larfym/fmcw-radar/Generador de Chirp/Informe/referencias.tex

% ==========================================
% REFERENCIAS
% ==========================================

\renewcommand{\bibname}{Referencias}
\begin{thebibliography}{99}
\setcounter{enumiv}{9}   % clave: va DESPUÉS del \begin, así no te lo pisa \usecounter
\setlength{\itemsep}{0.25em}
\setlength{\parskip}{0pt}
\setlength{\parsep}{0pt}

\bibitem{mitRadar}
C.~R. Rappaport, A.~M. Hersch, M.~A. Saville, and A.~J. Devaney,
``MIT IAP Radar Course: Build a Small Radar System (Coffee Can Radar),''
\emph{Massachusetts Institute of Technology, Lincoln Laboratory},
Lexington, MA, USA, 2011. [En línea]. Disponible en:
\url{https://ocw.mit.edu/courses/electrical-engineering-and-computer-science/6-976-high-frequency-radar-systems-january-iap-2011/}

\bibitem{MarshallBruner}
M. Bruner,
\emph{How Radars Tell Targets Apart (and When They Can’t) | Radar Resolution},
YouTube, 19 abr. 2025.
Disponible en:
\url{https://www.youtube.com/watch?v=MmpPfQ8WoWk}.

\bibitem{MiniCircuitsZX95}
Mini-Circuits,
\emph{ZX95-2536C+ Voltage Controlled Oscillator (VCO) Datasheet}.
Disponible en:
\url{https://www.minicircuits.com/WebStore/dashboard.html?model=ZX95-2536C%2B}

\bibitem{ADF4350}
Analog Devices,
\emph{ADF4350 Wideband Synthesizer with Integrated VCO -- Datasheet}.
Disponible en:
\url{https://www.analog.com/media/en/technical-documentation/data-sheets/ADF4350.pdf}

\bibitem{adf4159}
Analog Devices,
``ADF4159: 13~GHz Fractional-N Frequency Synthesizer with Ramp Generator,''
\emph{Datasheet}, 2019. [En línea].
Disponible en:
\url{https://www.analog.com/}

\bibitem{ADF4159EB3Z}
Analog Devices,
\emph{ADF4159EB3Z Evaluation Board for the ADF4159 PLL Synthesizer}.
Disponible en:
\url{https://www.analog.com/en/resources/evaluation-hardware-and-software/evaluation-boards-kits/eval-adf4159.html}

\bibitem{harney_pll}
A.~Harney,
``Designing High-Performance Phase-Locked Loops with High-Voltage VCOs,''
\emph{Analog Dialogue}.

\bibitem{gua_chirp}
C.~Gua, R.~Ding, Y.~Gao, G.~D.~Huang, D.~Sun, and S.~Liu,
``A Linear Chirp Generator with 2nd DPD Technique based on a Type-III SPLL.''

\bibitem{crystekVCO}
Crystek,
``CVCOS55BE Series VCO,''
\emph{Datasheet}, 2024. [En línea].
Disponible en:
\url{https://www.crystek.com/}

\bibitem{A Hasan}
A.~Hasan,
\emph{Novel Microstrip Hairpinline Narrowband Bandpass Filter Using Via Ground Holes}.

\bibitem{Chemandy}
Chemandy,
\emph{Coplanar Waveguide with Ground Calculator}.
Disponible en:
\url{https://chemandy.com/calculators/coplanar-waveguide-with-ground-calculator.htm}

\bibitem{StackExchangeVias}
Electronics Stack Exchange,
\emph{How to calculate distances between stitching vias for RF lines?}
Disponible en:
\url{https://electronics.stackexchange.com/questions/707177/how-to-calculate-distances-between-stitching-vias-for-rf-lines}

\bibitem{HansRosenbergVias}
Hans Rosenberg,
\emph{Why Ground Planes Can Break RF... And How to Fix It}.
Disponible en:
\url{https://www.youtube.com/watch?v=vumYrebIXm0}

\bibitem{AnalogDevices2012ADIsimPLL}
Analog Devices,
\emph{Using ADIsimPLL to Simulate Frequency Ramps on the ADF4158},
video, 18 de septiembre de 2012.
Disponible en:
\url{https://www.analog.com/en/resources/media-center/videos/1846356091001.html}.

\bibitem{AnalogDevices2015ADF4158}
Analog Devices,
``ADF4158 \& ADF4159 loop filter design,''
\emph{EngineerZone -- RF \& Microwave},
23 de junio de 2015.
Disponible en:
\url{https://ez.analog.com/rf/f/q-a/74295/adf4158-adf4159-loop-filter-design}.

\bibitem{op184}
Analog Devices,
``OP184/OP284/OP484: Precision Rail-to-Rail Input and Output Operational Amplifiers,''
\emph{Datasheet}. [En línea].
Disponible en:
\url{https://www.analog.com/}

\bibitem{LM7805}
Texas Instruments,
``LM340-N/LM78xx Positive-Voltage Regulators,''
\emph{Datasheet}. [En línea].
Disponible en:
\url{https://www.ti.com/lit/ds/symlink/lm340.pdf}

\end{thebibliography}
