larfym/fmcw-radar/Generador de Chirp/Informe/preambulo/acta aprobacion.tex

\thispagestyle{empty}

\begin{center}

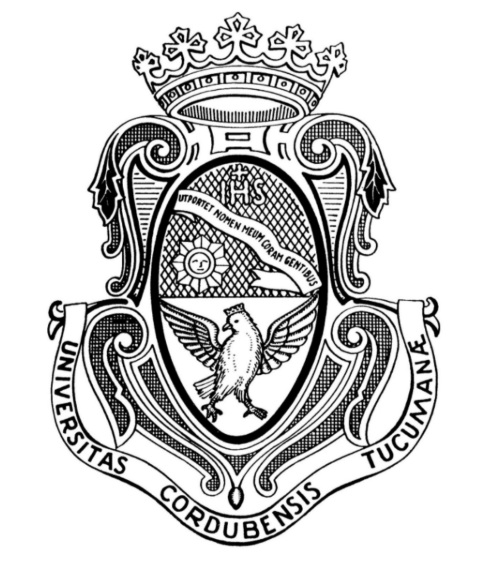
[picture p1: Generador de Chirp/Informe/imagenes/Escudo UNC.png]


\vspace{0.5cm}

{\Large\scshape Universidad Nacional de Córdoba}

\vspace{0.2cm}

{\large\scshape Facultad de Ciencias Exactas, Físicas y Naturales}

\vspace{0.2cm}

{\large\scshape Escuela de Ingeniería Electrónica}

\end{center}

\vspace{1.5cm}

\noindent
El Tribunal Evaluador reunido en este acto y luego de haber aprobado la Solicitud de
Aprobación de Tema y efectuado las distintas instancias de correcciones del Informe del
Proyecto Integrador para la obtención del Título de Grado ``Ingeniero Electrónico'' y
cumpliendo con el Reglamento correspondiente, declara el Informe Final del estudiante
\textbf{Cesana, Andrés Agustín} como ``aceptado sin correcciones'' y la defensa oral
Aprobada. Por lo tanto, luego de haber tenido en cuenta los aspectos de evaluación que
indica el Reglamento, el Proyecto Integrador se considera Aprobado.

\vspace{1cm}

\noindent
Se firma el Acta de Examen correspondiente y se distribuyen los ejemplares impresos.

\vfill

\noindent
Firma y aclaración del Tribunal Evaluador

\vspace{1.5cm}

\noindent
Fecha: \rule{6cm}{0.4pt}

\clearpage
