larfym/fmcw-radar/Generador de Chirp/Informe/preambulo/caratula.tex

\begin{titlepage}
\begin{center}

% --- Escudo ---
\\[1.5cm] % Asegurate de tener el archivo en la misma carpeta

{\centering
{\LARGE
\textbf{UNIVERSIDAD NACIONAL DE CÓRDOBA}}\\[0.5cm]
{\large
{FACULTAD DE CIENCIAS EXACTAS FÍSICAS Y NATURALES}\\[0.5cm]
{CARRERA INGENIERÍA ELECTRÓNICA }}}
\\[2.0cm] 
PROYECTO INTEGRADOR PARA LA OBTENCIÓN DEL TÍTULO DE GRADO DE INGENIERO ELECTRÓNICO \\
[2.0cm]
{\textbf{\large "DISEÑO E IMPLEMENTACIÓN DE UN GENERADOR DE CHIRP PARA RADARES FMCW"}}\\
[1.0cm]

\hrule height 1pt
\vspace{0.5cm}
\hrule height 1pt
\vspace{1cm}

\textbf{ALUMNO:}\\ CESANA, ANDRÉS AGUSTÍN\\[0.5cm]
\textbf{DIRECTOR:}\\ FEDERICO TOMÁS DADAM \\[0.5cm]
\textbf{CO-DIRECTOR:}\\ FEDERICO EXEQUIEL HENRIQUEZ\\[2.2cm]

% --- Autor ---
{Córdoba, República Argentina\\
Septiembre / 2026}

\end{center}
\end{titlepage}
\clearpage
