larfym/fmcw-radar/Generador de Chirp/Informe/preambulo/director.tex

\clearpage
\thispagestyle{empty}

\begin{center}



\vspace{0.5cm}

{\Large\scshape Universidad Nacional de Córdoba}

\vspace{0.2cm}

{\large\scshape Facultad de Ciencias Exactas, Físicas y Naturales}

\vspace{0.2cm}

{\large\scshape Escuela de Ingeniería Electrónica}

\end{center}

\vspace{1.5cm}

\begin{center}
\begin{minipage}{0.85\textwidth}

\noindent
Quien suscribe el Profesor \textbf{Dadam, Federico Tomás} en su carácter de Director
del Proyecto Integrador del estudiante \textbf{Cesana, Andrés Agustín}, denominado:

\begin{center}
\textbf{``DISEÑO E IMPLEMENTACIÓN DE UN GENERADOR DE CHIRP PARA RADARES FMCW''}
\end{center}

considera que el desarrollo del trabajo se ha completado según lo especificado en la
Solicitud de Aprobación de Tema y se encuentra en condiciones de tramitar su defensa.

\vspace{0.8cm}

\noindent
A los efectos de quien corresponda, en fecha \rule{4cm}{0.4pt} de
\rule{4cm}{0.4pt} de 2026.

\vspace{3cm}

\begin{flushright}
\rule{7cm}{0.4pt}\\
Firma del Director
\end{flushright}

\end{minipage}
\end{center}

\clearpage
