larfym/fmcw-radar/Generador de Chirp/Informe/preambulo/lista de acronimos.tex

\chapter*{Lista de Acrónimos} 
\noindent\textbf{ADS}{Advanced Design System}\\
\textbf{CAD}{Computer-Aided Design}\\
\textbf{CPWG}{Coplanar Waveguide with Ground}\\
\textbf{FMCW}{Frequency-Modulated Continuous-Wave}\\
\textbf{LARFyM}{Laboratorio de Radiofrecuencia y Microondas}\\
\textbf{LFM}{Linear Frequency Modulation}\\
\textbf{LNA}{Low Noise Amplifier}\\
\textbf{MXR}{Mixer}\\
\textbf{OCXO}{Oven Controlled Crystal Oscillator}\\
\textbf{PA}{Power Amplifier}\\
\textbf{PCB}{Printed Circuit Board}\\
\textbf{PFD}{Phase Frequency Detector}\\
\textbf{PLL}{Phase-Locked Loop}\\
\textbf{PSK}{Phase Shift Keying}\\
\textbf{RADAR}{Radio Detection and Ranging}\\
\textbf{RF}{Radiofrecuencia}\\
\textbf{SDR}{Software Defined Radio}\\
\textbf{TCXO}{Temperature Compensated Crystal Oscillator}\\
\textbf{UV}{Ultravioleta}\\
\textbf{VCO}{Voltage Controlled Oscillator}\\
\textbf{VCXO}{Voltage Controlled Crystal Oscillator}\\
\textbf{XO}{Crystal Oscillator}
