larfym/fmcw-radar/Generador de Chirp/Informe/bibliografia.tex

% ==========================================
% BIBLIOGRAFÍA
% ==========================================
\renewcommand{\bibname}{Bibliografía}
\begin{thebibliography}{99}
\setlength{\itemsep}{0.25em}
\setlength{\parskip}{0pt}
\setlength{\parsep}{0pt}

\bibitem{Charvat2014}
G.~L. Charvat, \emph{Small and Short-Range Radar Systems}.

\bibitem{Dean Banerjee}
D. Banerjee, \emph{PLL Performance, Simulation, and Design}, 2.\,ed.

\bibitem{pozar}
D.~M. Pozar, \emph{Microwave Engineering}, 4.\,ed. Hoboken, NJ: Wiley, 2012.

\bibitem{skolnik2001}
M.~I. Skolnik, \emph{Introduction to Radar Systems}, 3.\,ed. New York, NY: McGraw-Hill Education, 2001.

\bibitem{richards2014}
M.~A. Richards, \emph{Fundamentals of Radar Signal Processing}, 2.\,ed. New York, NY: McGraw-Hill Education, 2014.

\bibitem{Andy Harrison}
A.~Harrison, \emph{Design and Implementation of FMCW Radar Systems for Range and Velocity Measurement}.
Tesis de Maestría, University of Leeds, Reino Unido, 2018.

\bibitem{CervettoDadam2019}
R.~H. Cervetto and F.~T. Dadam,
\emph{UP Converter de HF a UHF para aplicaciones LTE}.
Proyecto Integrador para la obtención del título de grado de Ingeniero Electrónico,
Facultad de Ciencias Exactas, Físicas y Naturales,
Universidad Nacional de Córdoba,
Córdoba, República Argentina, junio de 2019.

\bibitem{HongLancaster}
J.-S.~G. Hong and M.~J. Lancaster,
\emph{Microstrip Filters for RF/Microwave Applications}.
New York, NY: John Wiley \& Sons, 2001.

\bibitem{Matthaei}
G.~L. Matthaei, L.~Young, and E.~M.~T. Jones,
\emph{Microwave Filters, Impedance-Matching Networks, and Coupling Structures}.
Norwood, MA: Artech House, 1980.

\end{thebibliography}
