larfym/fmcw-radar/Generador de Chirp/Informe/preambulo/lista de tablas.tex

\chapter*{Lista de Tablas} 
\addcontentsline{toc}{chapter}{Lista de Tablas}
