larfym/fmcw-radar/Generador de Chirp/Practica Supervisada/Datos administrativos/Gantt PS Andrés Agustín Cesana.docx

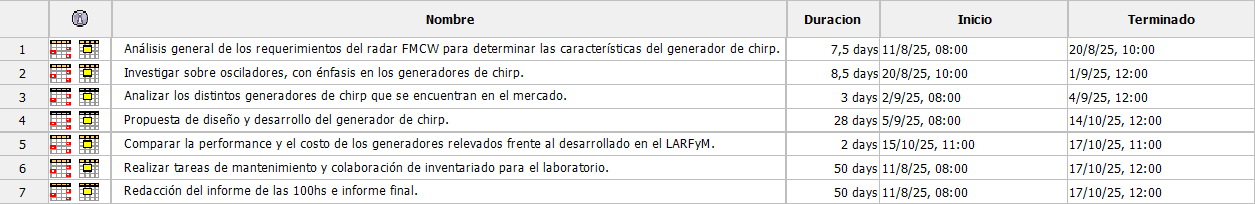
[picture p75: figure]
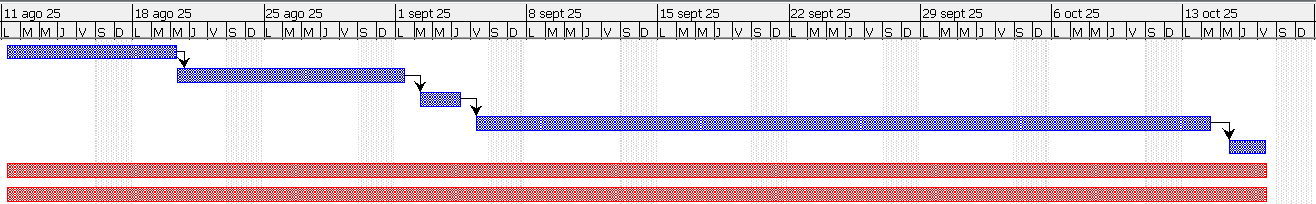
[picture p76: figure]
