larfym/fmcw-radar/Generador de Chirp/Proyecto Integrador/filtro lazo/filtro1mascara.pdf

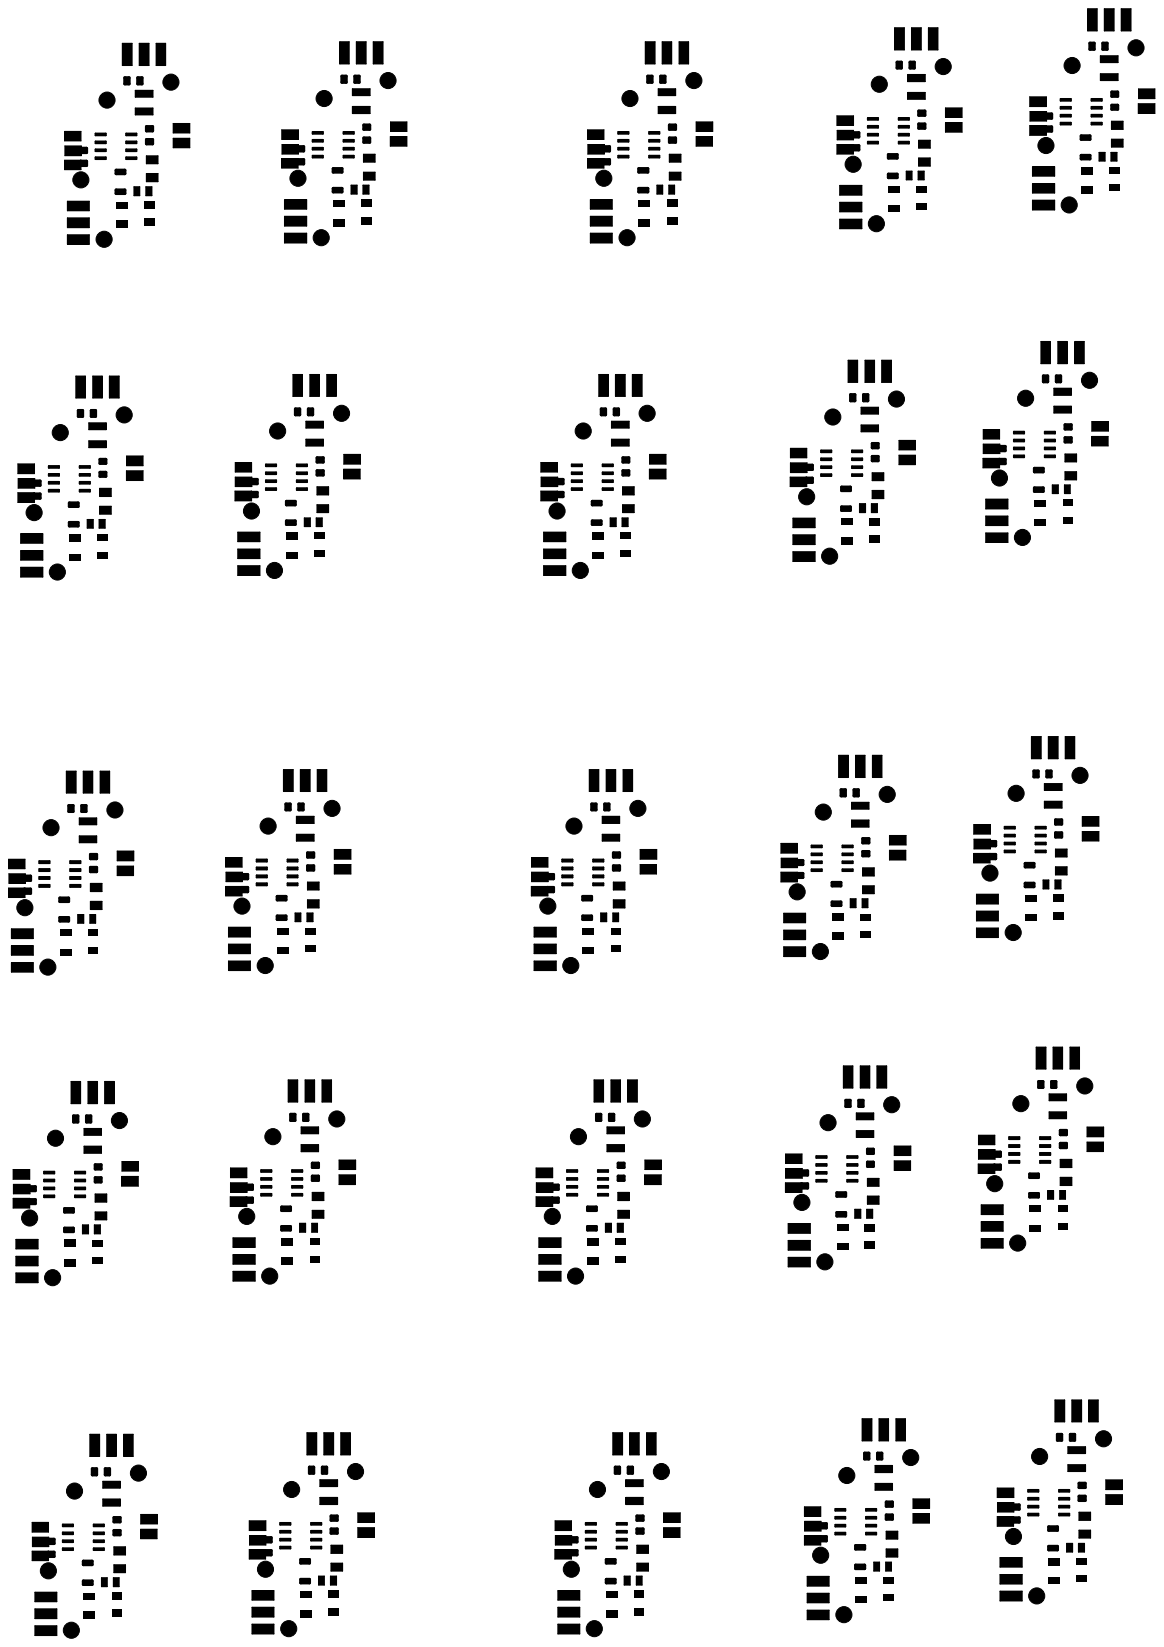
[picture p77: page 1]
