larfym/fmcw-radar/Generador de Chirp/Proyecto Integrador/filtro lazo/filtro2masc.pdf

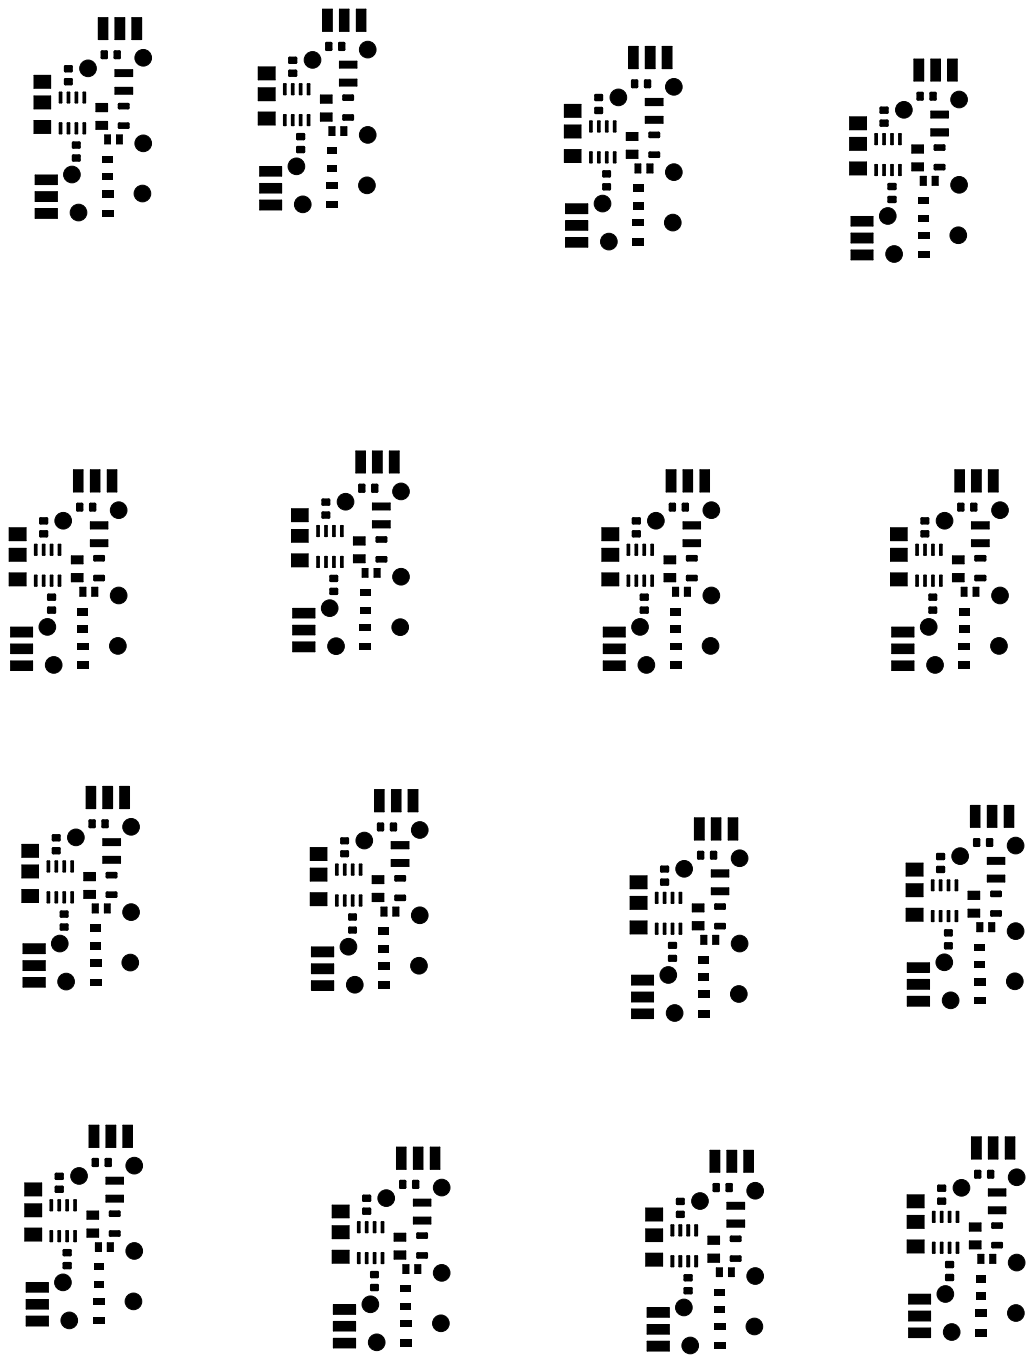
[picture p78: page 1]
