larfym/fmcw-radar/Generador de Chirp/Proyecto Integrador/filtro lazo/filtro3mascara.pdf

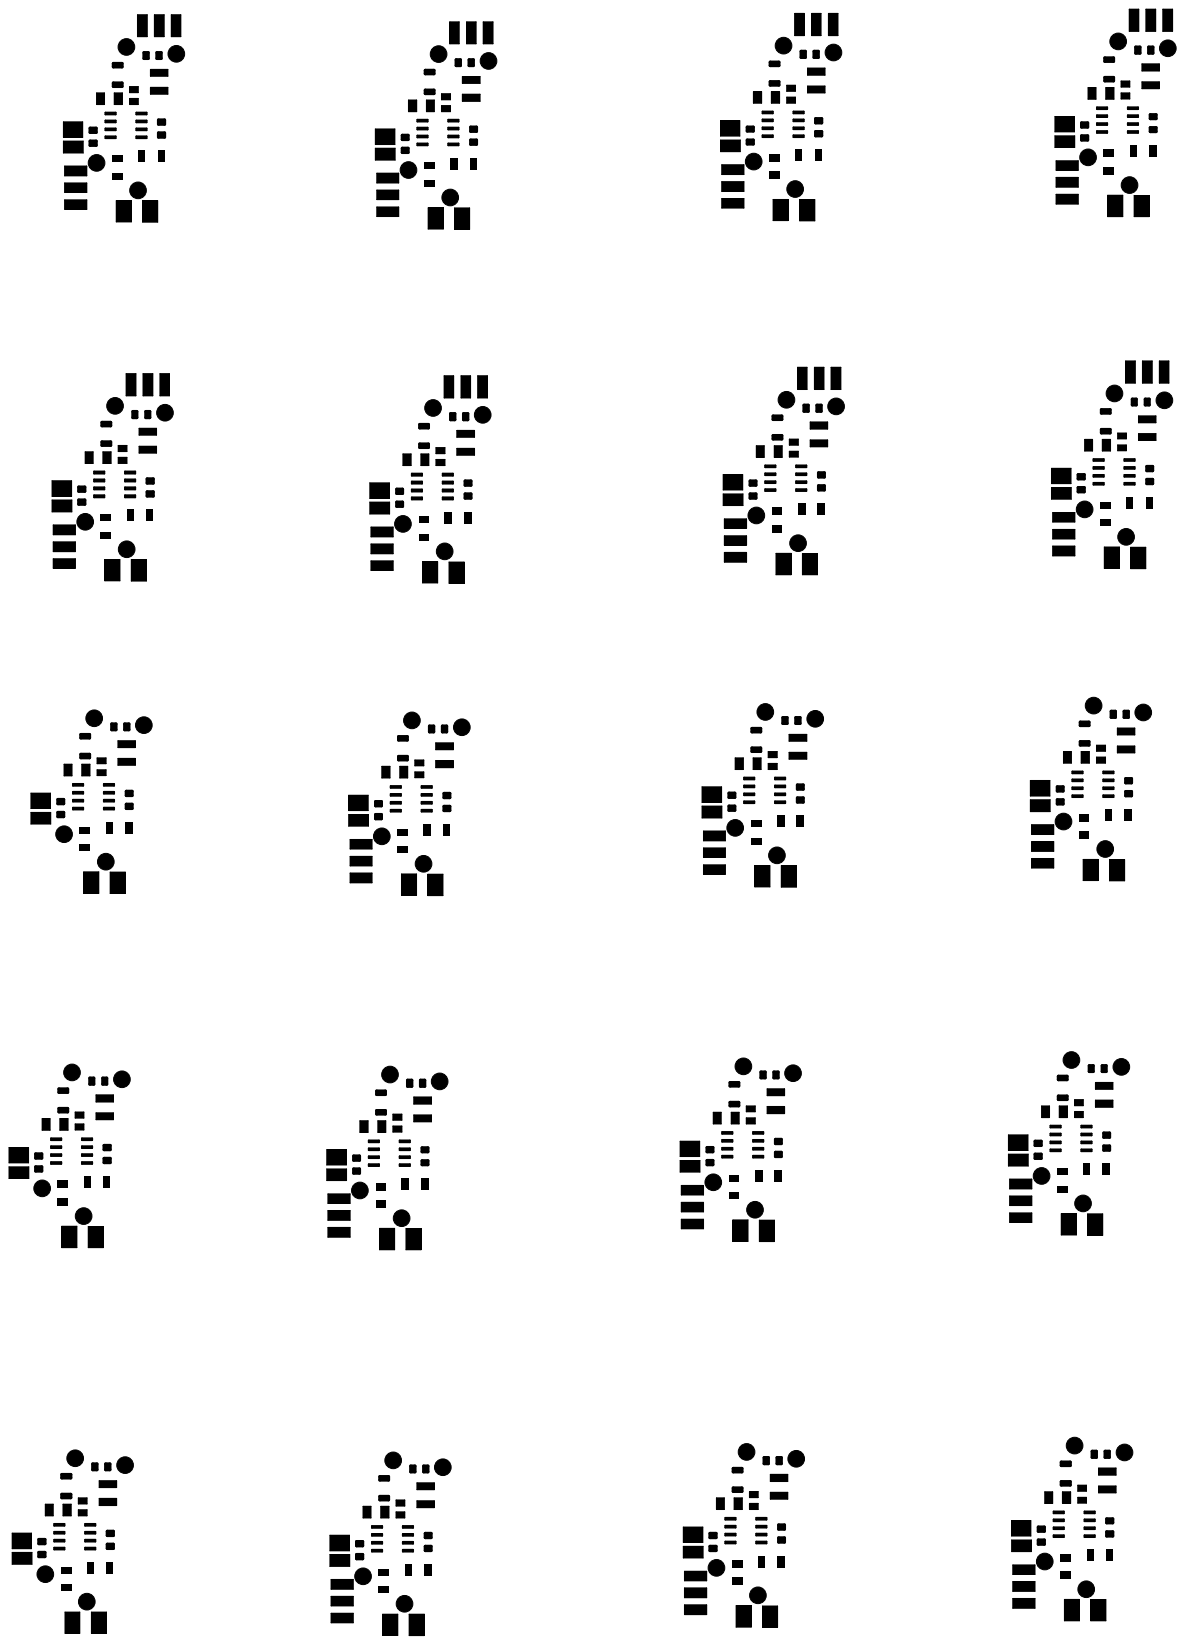
[picture p79: page 1]
