larfym/fmcw-radar/Generador de Chirp/Informe/imagenes/Diagrama en bloque PLL.png

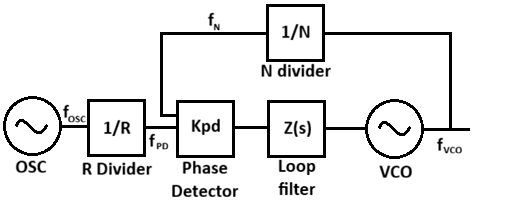
Generador de Chirp/Informe/imagenes/Diagrama en bloque PLL.png
