larfym/fmcw-radar/Generador de Chirp/Informe/imagenes/funcion de transferencia.png

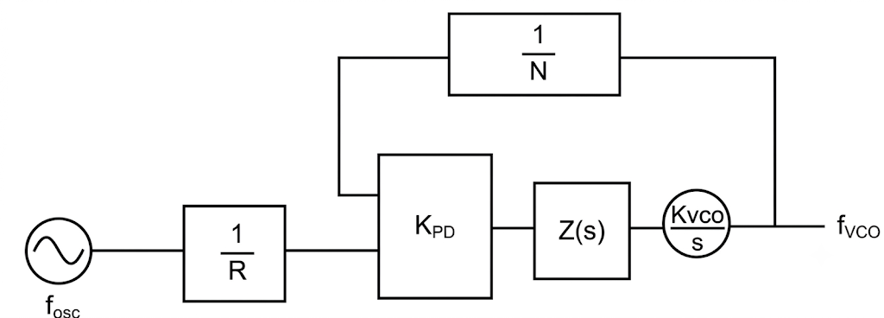
Generador de Chirp/Informe/imagenes/funcion de transferencia.png
