larfym/fmcw-radar/Generador de Chirp/Practica Supervisada/Descarga osciloscopio/NewFile0.bmp

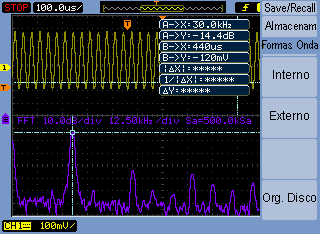
Generador de Chirp/Practica Supervisada/Descarga osciloscopio/NewFile0.bmp
