larfym/fmcw-radar/Generador de Chirp/Practica Supervisada/Imagenes/Capacidad de exitacion.png

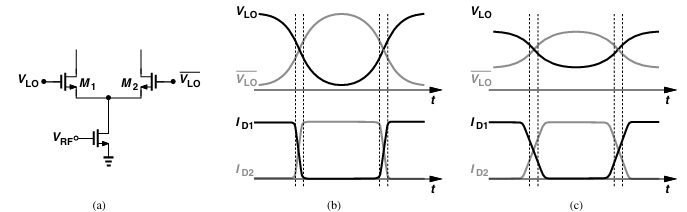
Generador de Chirp/Practica Supervisada/Imagenes/Capacidad de exitacion.png
