larfym/fmcw-radar/Generador de Chirp/Practica Supervisada/Imagenes/Condicion de frontera.png

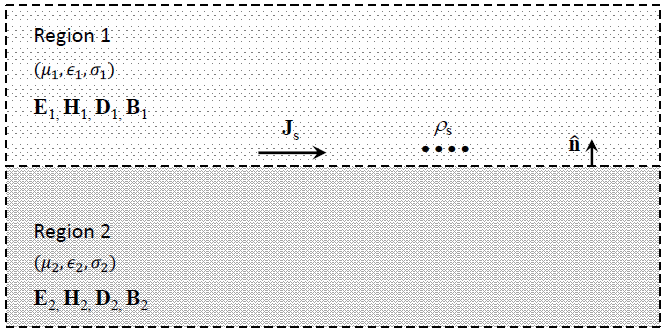
Generador de Chirp/Practica Supervisada/Imagenes/Condicion de frontera.png
