larfym/fmcw-radar/Generador de Chirp/Practica Supervisada/Imagenes/Oscilador cruz doble.png

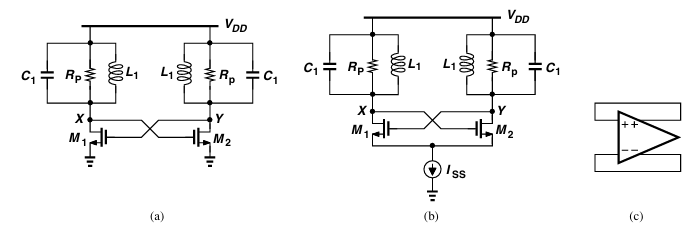
Generador de Chirp/Practica Supervisada/Imagenes/Oscilador cruz doble.png
