larfym/fmcw-radar/Generador de Chirp/Practica Supervisada/Imagenes/Oscilador cruz.png

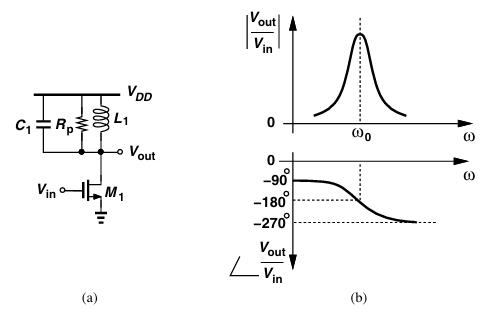
Generador de Chirp/Practica Supervisada/Imagenes/Oscilador cruz.png
