larfym/fmcw-radar/Generador de Chirp/Practica Supervisada/Imagenes/Oscilador de tres puerto.png

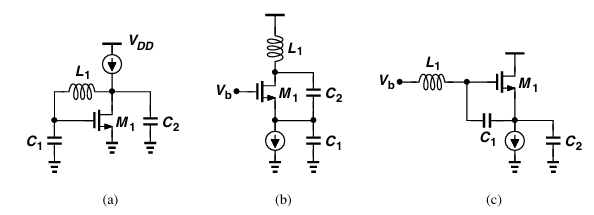
Generador de Chirp/Practica Supervisada/Imagenes/Oscilador de tres puerto.png
