larfym/fmcw-radar/Generador de Chirp/Practica Supervisada/Imagenes/Oscilador de un puerto.png

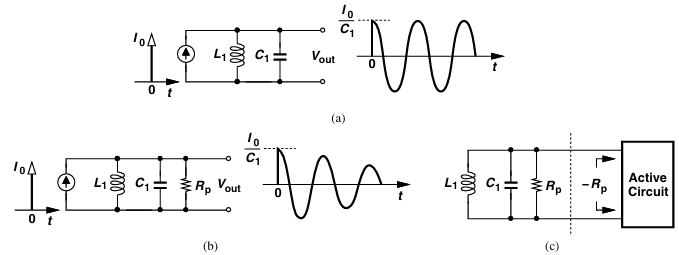
Generador de Chirp/Practica Supervisada/Imagenes/Oscilador de un puerto.png
