larfym/fmcw-radar/Generador de Chirp/Practica Supervisada/Imagenes/Oscilador tres diferencial.png

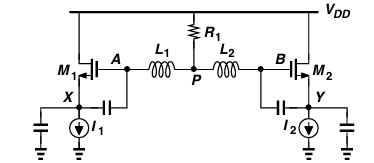
Generador de Chirp/Practica Supervisada/Imagenes/Oscilador tres diferencial.png
