larfym/fmcw-radar/Generador de Chirp/Practica Supervisada/Imagenes/Radar FMCW bloques.png

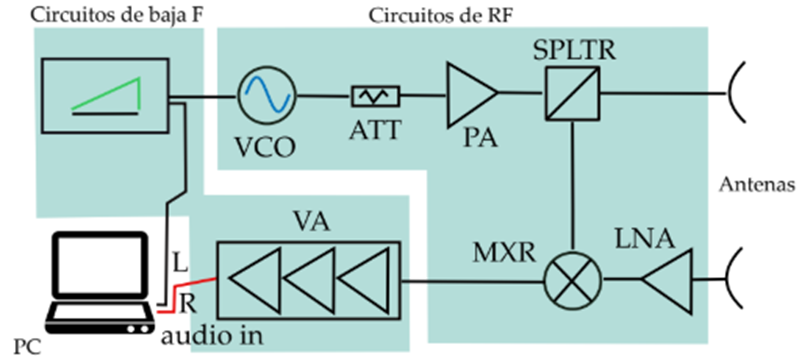
Generador de Chirp/Practica Supervisada/Imagenes/Radar FMCW bloques.png
