larfym/fmcw-radar/Generador de Chirp/Practica Supervisada/Imagenes/rampa.png

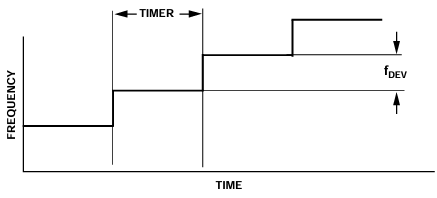
Generador de Chirp/Practica Supervisada/Imagenes/rampa.png
