larfym/fmcw-radar/Generador de Chirp/Practica Supervisada/Imagenes/Sin título.png

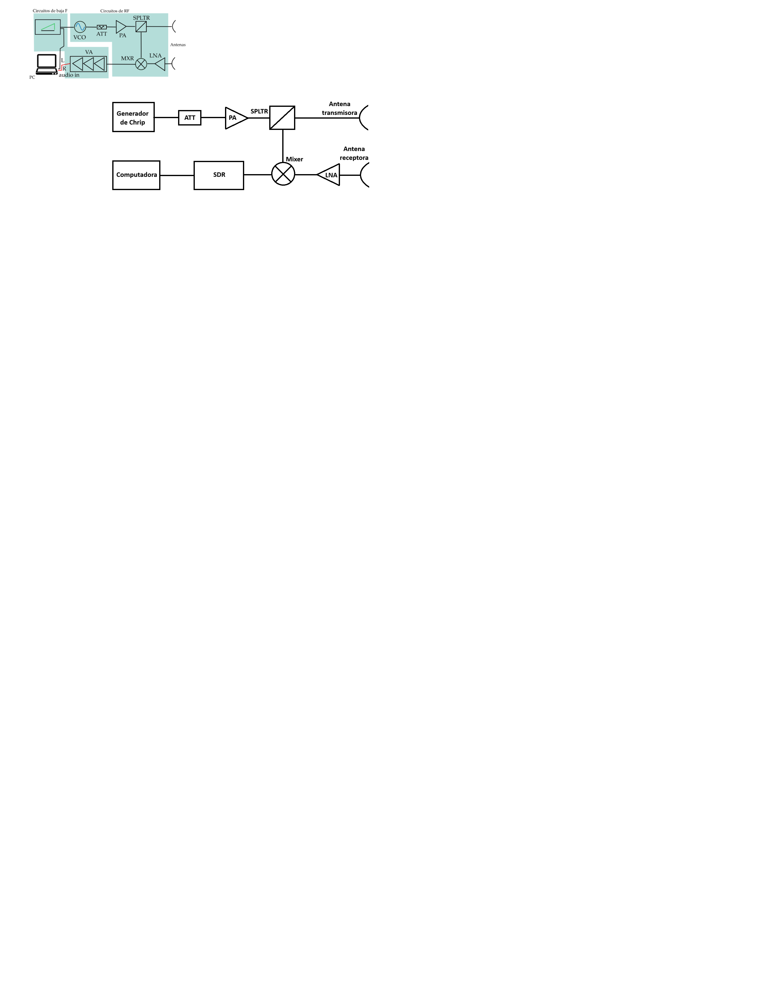
Generador de Chirp/Practica Supervisada/Imagenes/Sin título.png
