larfym/fmcw-radar/Generador de Chirp/Practica Supervisada/Imagenes/VCO recta.png

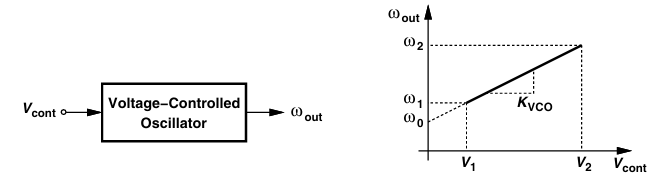
Generador de Chirp/Practica Supervisada/Imagenes/VCO recta.png
