larfym/fmcw-radar/Generador de Chirp/Practica Supervisada/Imagenes/vco varicap.png

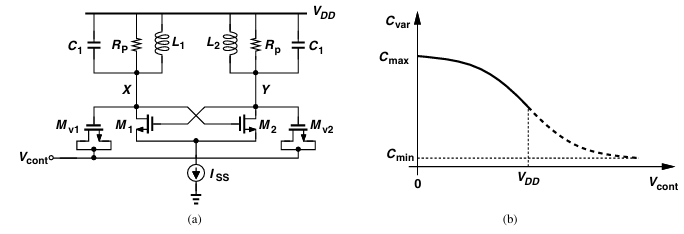
Generador de Chirp/Practica Supervisada/Imagenes/vco varicap.png
