larfym/fmcw-radar/Generador de Chirp/Practica Supervisada/Simulaciones/beat_BW_25MHz.png

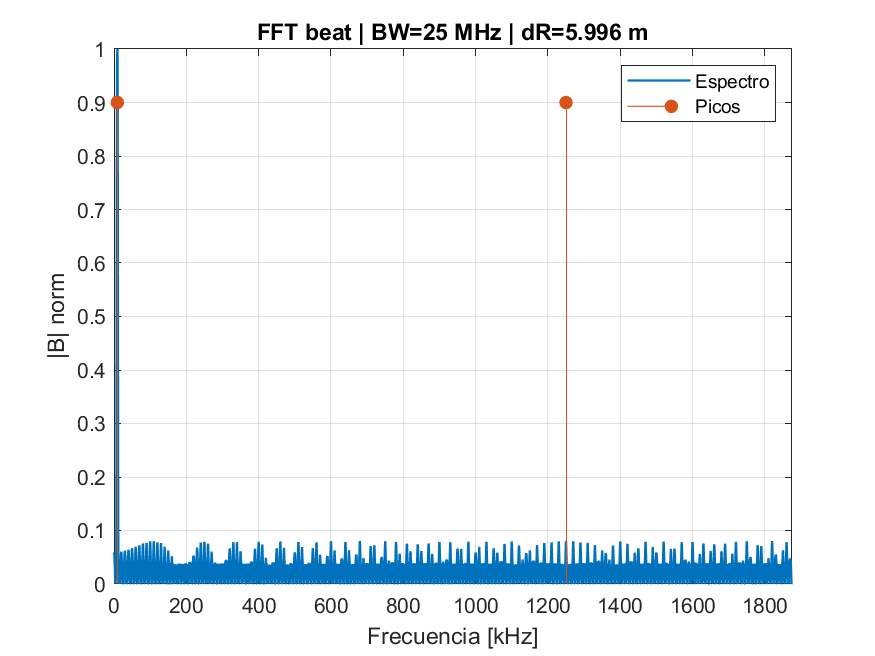
Generador de Chirp/Practica Supervisada/Simulaciones/beat_BW_25MHz.png
