larfym/fmcw-radar/Generador de Chirp/Practica Supervisada/Simulaciones/beat_BW_300MHz.png

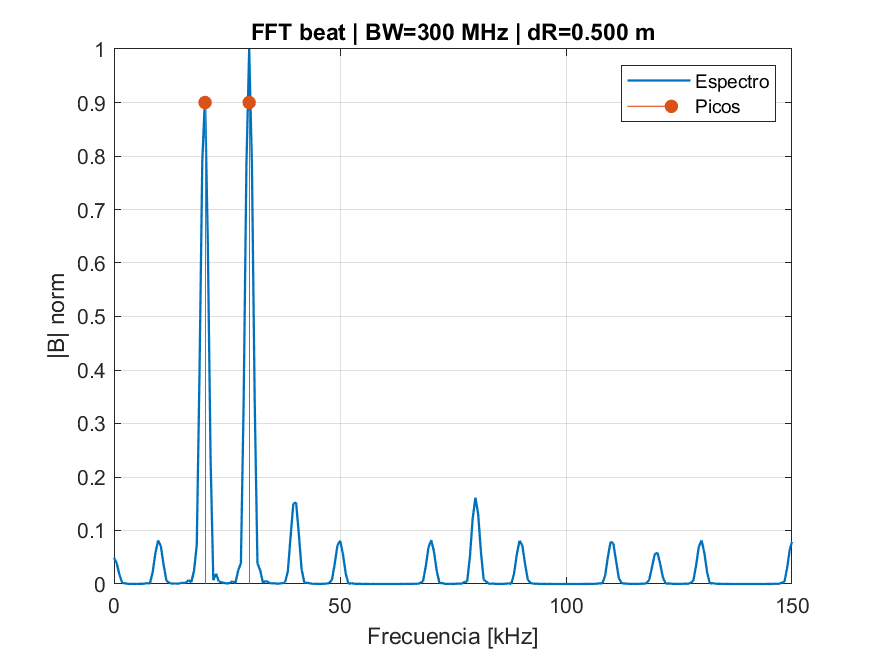
Generador de Chirp/Practica Supervisada/Simulaciones/beat_BW_300MHz.png
