larfym/fmcw-radar/Generador de Chirp/Practica Supervisada/Simulaciones/deteccion_coherente.png

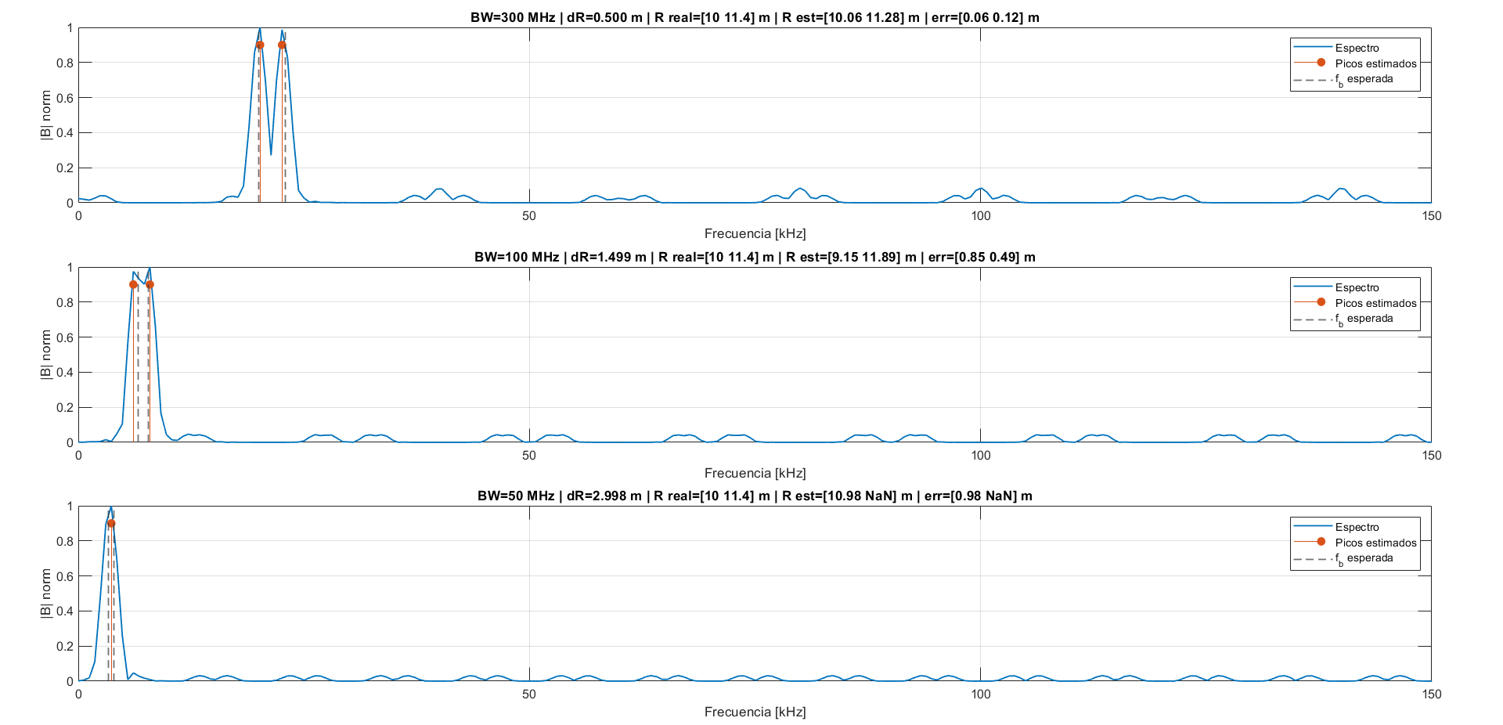
Generador de Chirp/Practica Supervisada/Simulaciones/deteccion_coherente.png
