larfym/fmcw-radar/Generador de Chirp/Proyecto Integrador/coupler/s11_s13.png

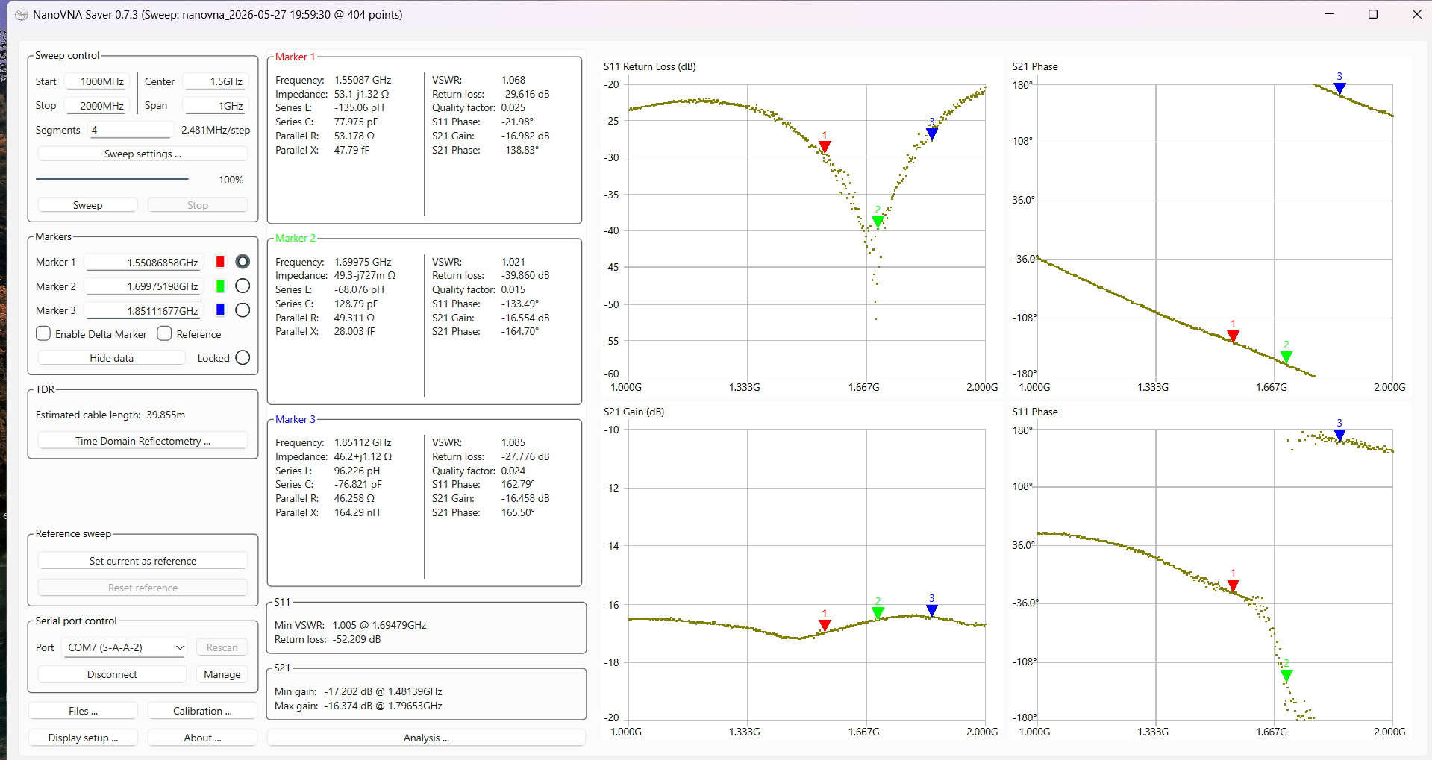
Generador de Chirp/Proyecto Integrador/coupler/s11_s13.png
