larfym/fmcw-radar/Generador de Chirp/Proyecto Integrador/coupler/s12.png

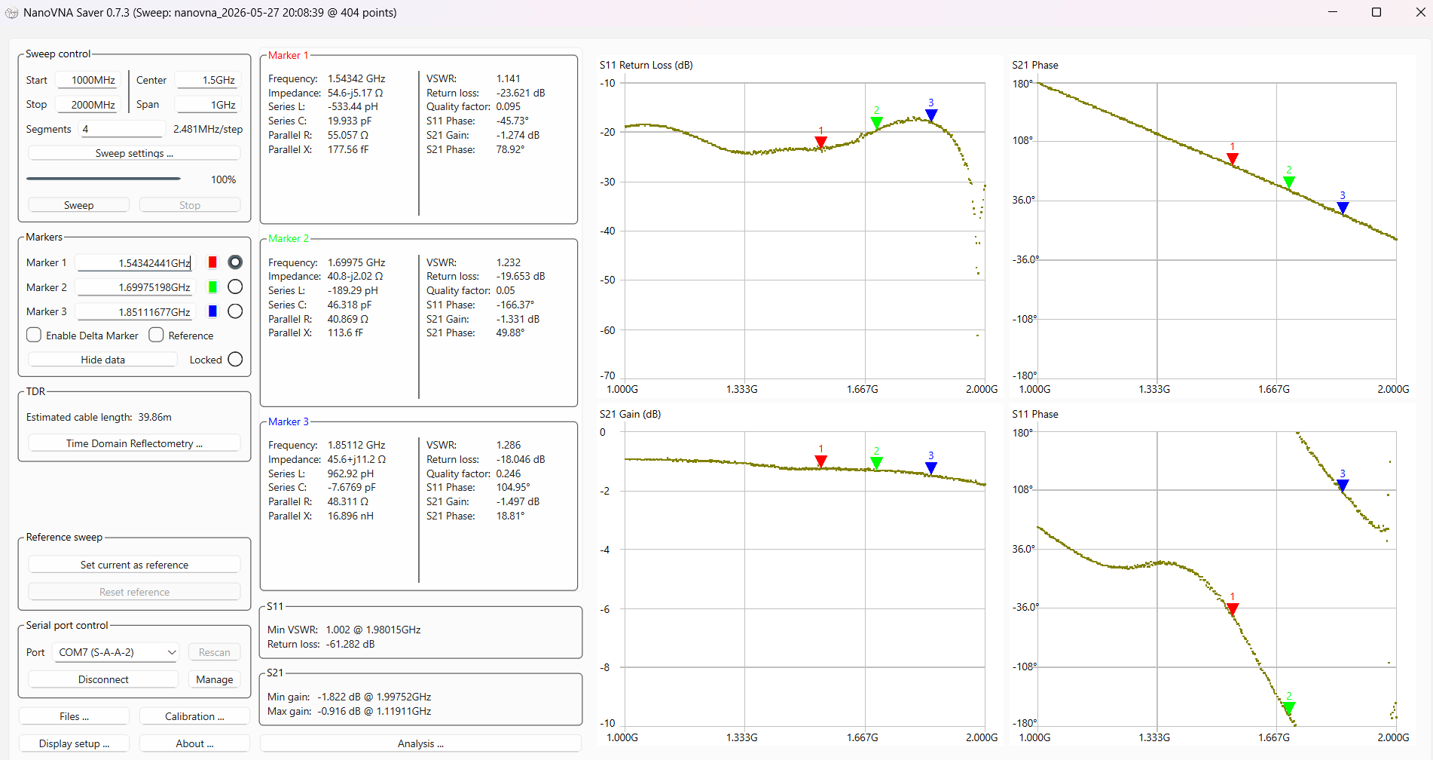
Generador de Chirp/Proyecto Integrador/coupler/s12.png
