larfym/fmcw-radar/Generador de Chirp/Proyecto Integrador/coupler/s23.png

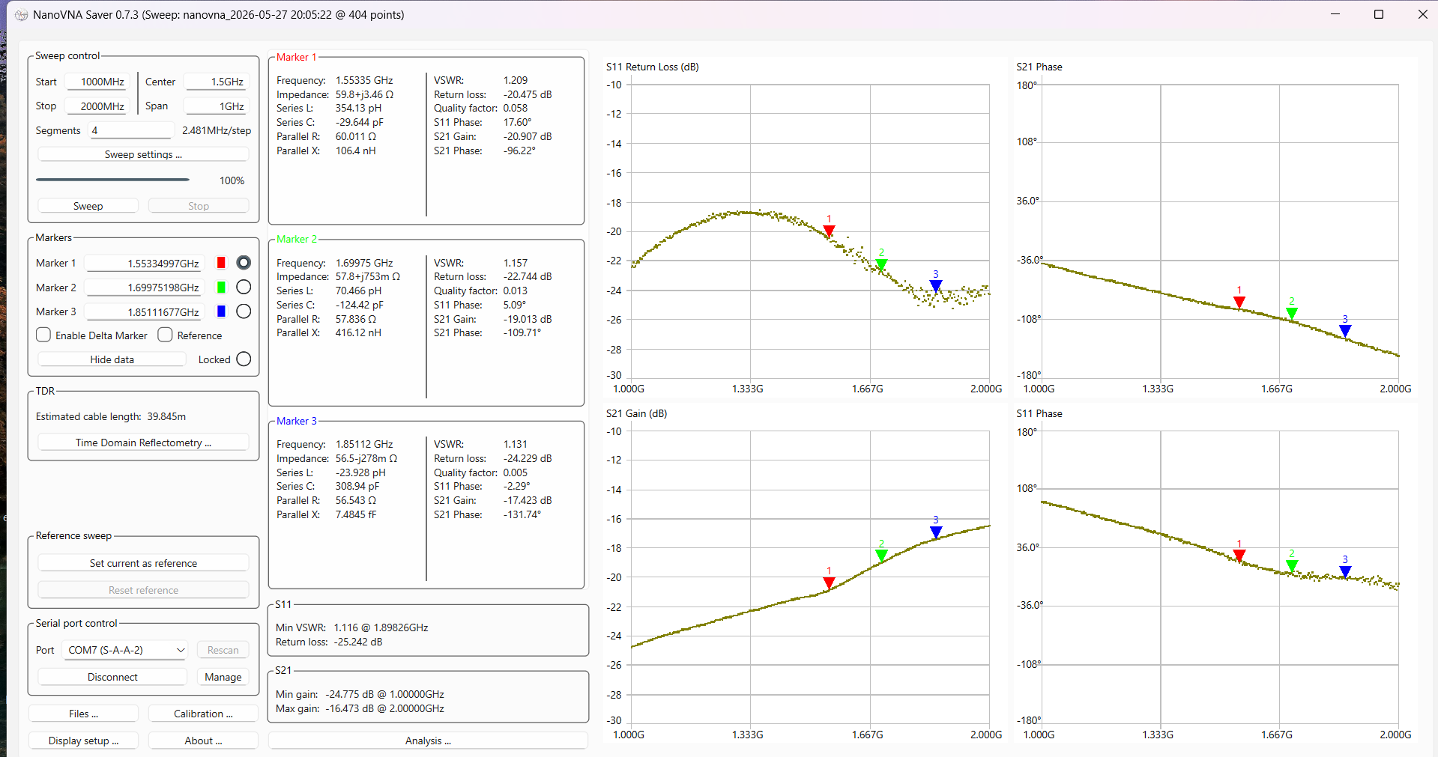
Generador de Chirp/Proyecto Integrador/coupler/s23.png
