larfym/fmcw-radar/Generador de Chirp/Proyecto Integrador/filtrowilk/s11_filt.png

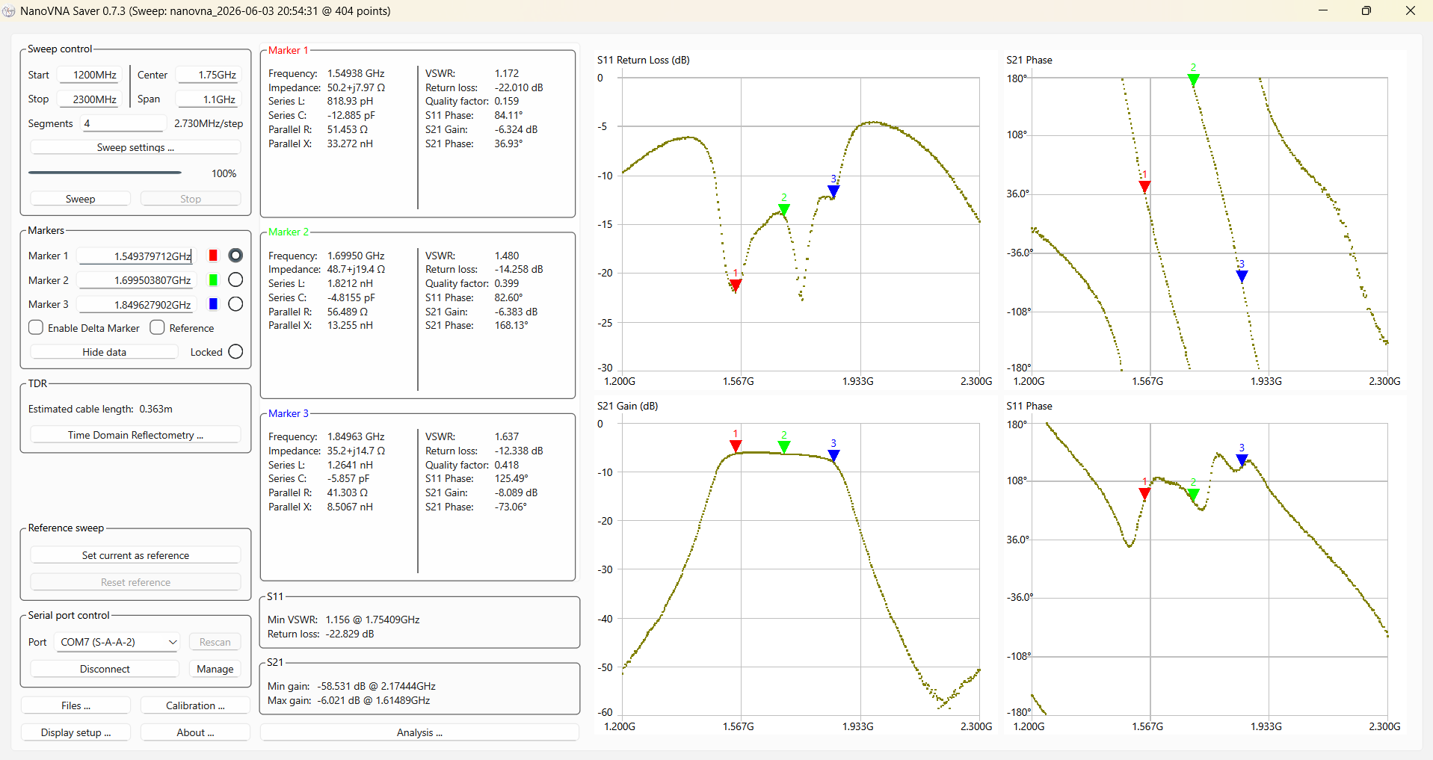
Generador de Chirp/Proyecto Integrador/filtrowilk/s11_filt.png
