larfym/fmcw-radar/Generador de Chirp/Proyecto Integrador/filtrowilk/s11_wilk.png

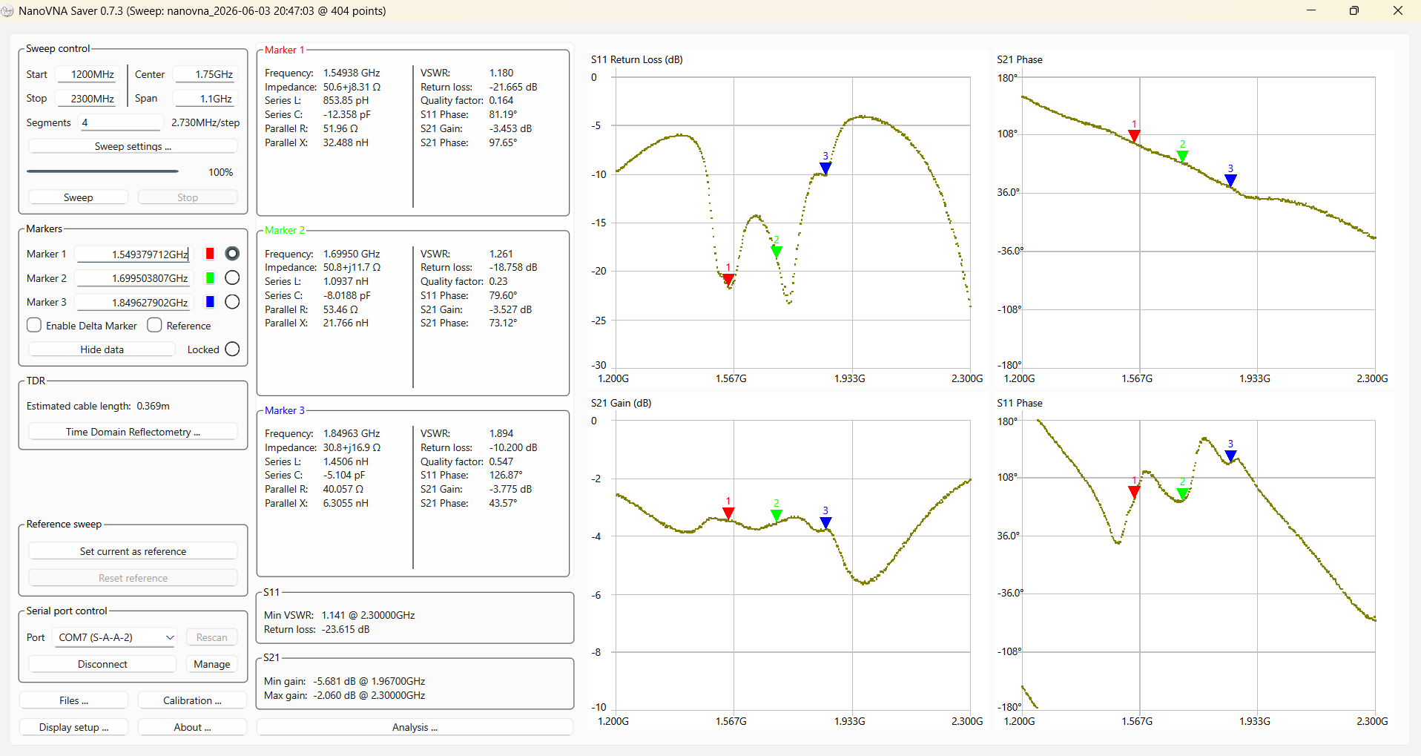
Generador de Chirp/Proyecto Integrador/filtrowilk/s11_wilk.png
