larfym/fmcw-radar/Generador de Chirp/Proyecto Integrador/caja/caja_parte_1.stl

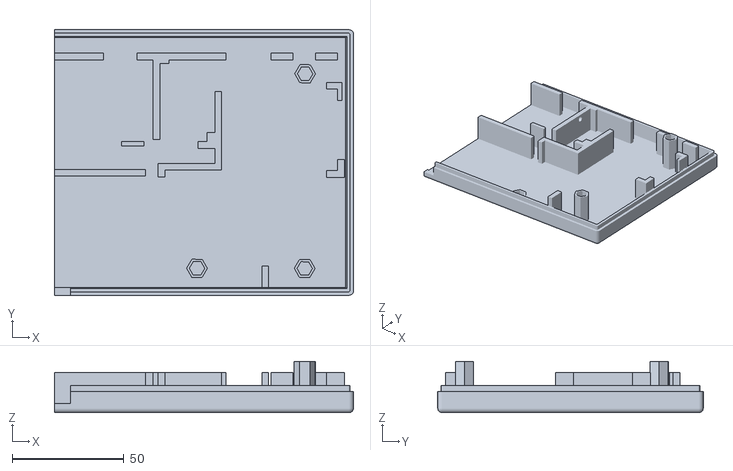
[picture p107: CAD file, 2026-09-05]
Generador de Chirp/Proyecto Integrador/caja/caja_parte_1.stl
134.0 x 119.0 x 23.0
