larfym/fmcw-radar/Generador de Chirp/Proyecto Integrador/filtro lazo/C0805C104K5RACTU/CAPC220145_88N_KEM.stl

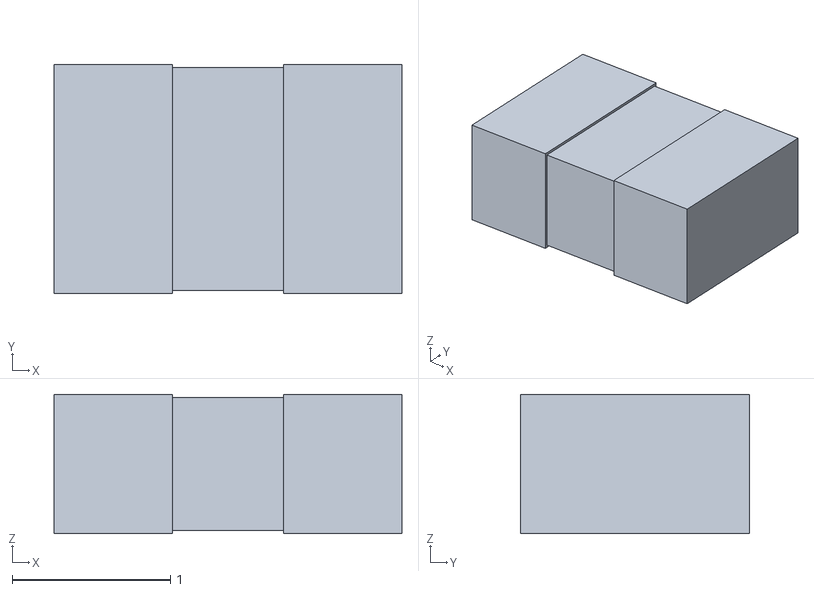
[picture p108: CAD file, 2026-09-05]
Generador de Chirp/Proyecto Integrador/filtro lazo/C0805C104K5RACTU/CAPC220145_88N_KEM.stl
2.20 x 1.45 x 0.88
