larfym/fmcw-radar/Generador de Chirp/Proyecto Integrador/filtro lazo/CON-SMA-EDGE-S/CON-SMA-EDGE-S.step

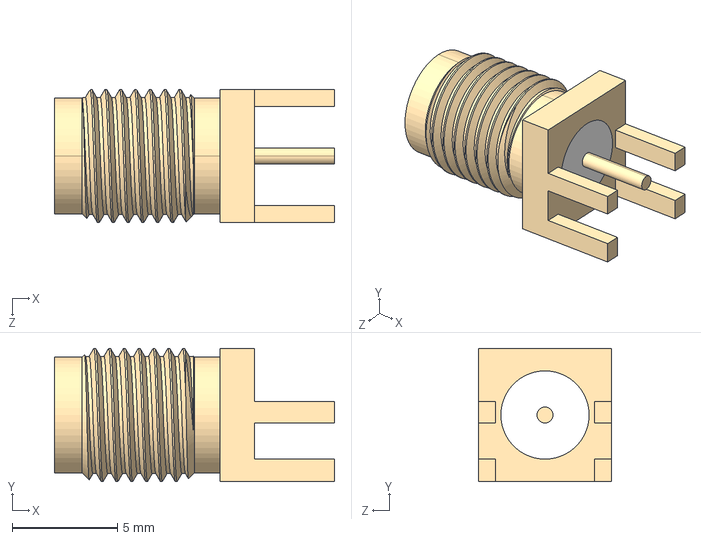
[picture p109: CAD file, 2026-09-05]
Generador de Chirp/Proyecto Integrador/filtro lazo/CON-SMA-EDGE-S/CON-SMA-EDGE-S.step
13.3 x 6.35 x 6.35 mm
