larfym/fmcw-radar/Generador de Chirp/Proyecto Integrador/filtro lazo/GRM31A5C2J221FW01D/GRM31A5C2J221FW01D.step

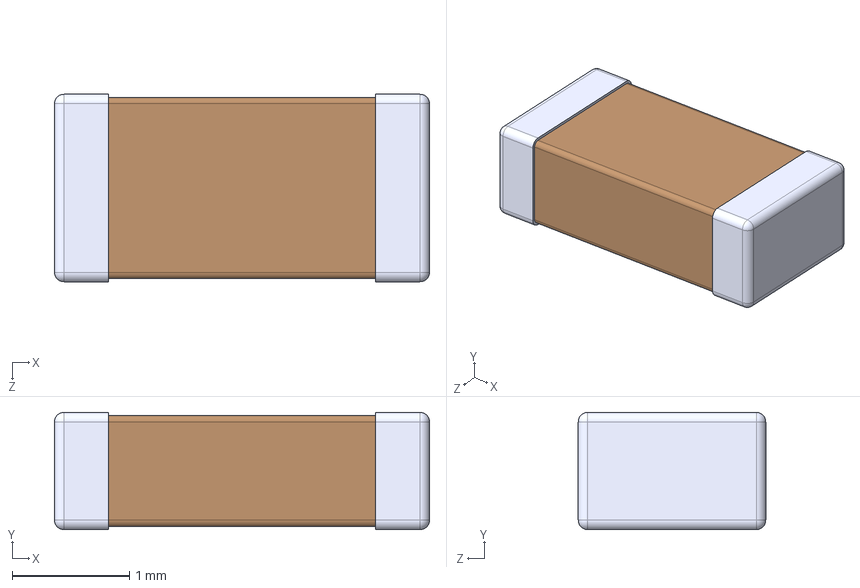
[picture p110: CAD file, 2026-09-05]
Generador de Chirp/Proyecto Integrador/filtro lazo/GRM31A5C2J221FW01D/GRM31A5C2J221FW01D.step
3.20 x 1.00 x 1.60 mm
