larfym/fmcw-radar/Generador de Chirp/Proyecto Integrador/filtro lazo/L7805CD2T_TR/L7805CD2T-TR.step

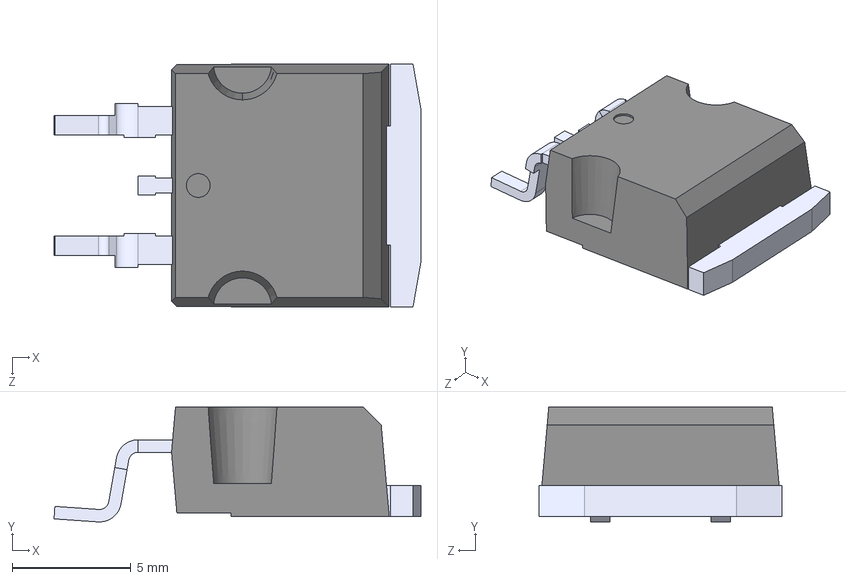
[picture p111: CAD file, 2026-09-05]
Generador de Chirp/Proyecto Integrador/filtro lazo/L7805CD2T_TR/L7805CD2T-TR.step
15.4 x 4.83 x 10.2 mm
