larfym/fmcw-radar/Generador de Chirp/Proyecto Integrador/filtro lazo/RC0805FR-07330RL/RC0805FR-07330RL.step

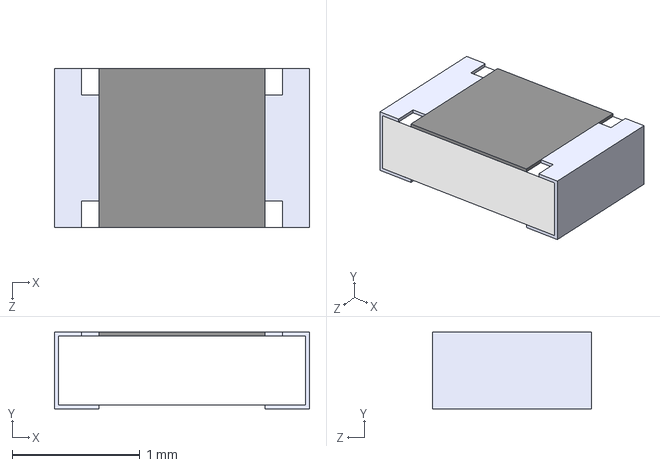
[picture p112: CAD file, 2026-09-05]
Generador de Chirp/Proyecto Integrador/filtro lazo/RC0805FR-07330RL/RC0805FR-07330RL.step
2.00 x 0.6 x 1.25 mm
