larfym/fmcw-radar/Generador de Chirp/Proyecto Integrador/filtro lazo/RT1210FRE07100RL/RT1210FRE07100RL.step

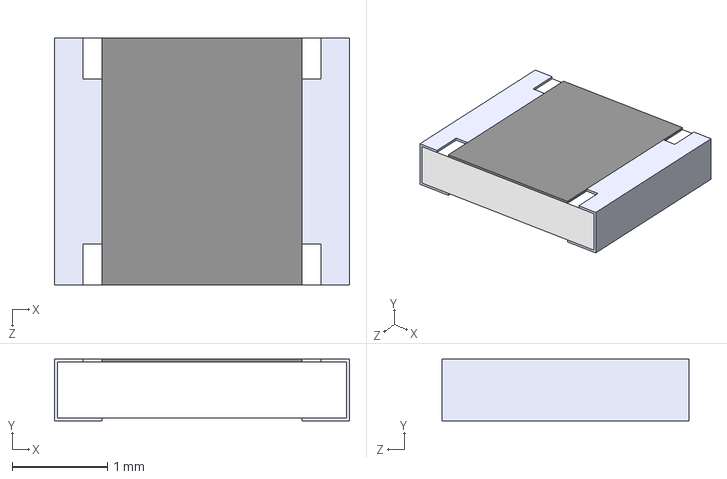
[picture p113: CAD file, 2026-09-05]
Generador de Chirp/Proyecto Integrador/filtro lazo/RT1210FRE07100RL/RT1210FRE07100RL.step
3.10 x 0.65 x 2.60 mm
