larfym/fmcw-radar/Generador de Chirp/Proyecto Integrador/filtro lazo/USR1H0R1MDD/CAP_4X7_NCH.step

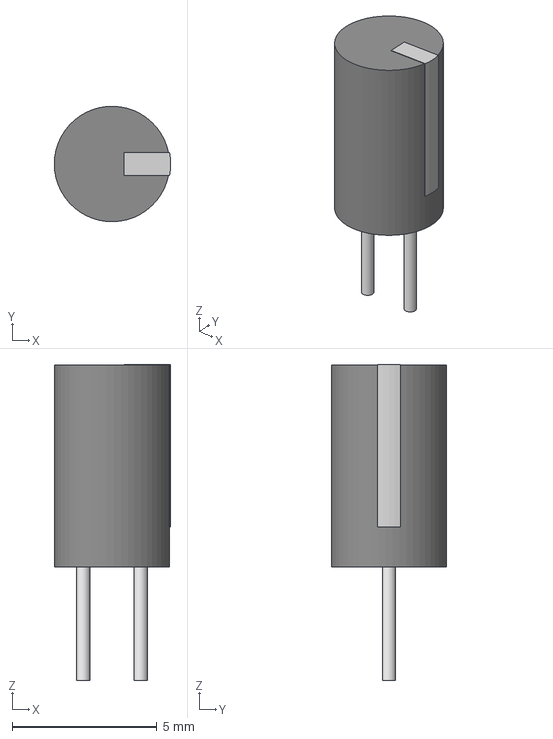
[picture p114: CAD file, 2026-09-05]
Generador de Chirp/Proyecto Integrador/filtro lazo/USR1H0R1MDD/CAP_4X7_NCH.step
4.02 x 3.99 x 10.9 mm
