larfym/fmcw-radar/Generador de Chirp/Proyecto Integrador/caja/tapa continua.stl

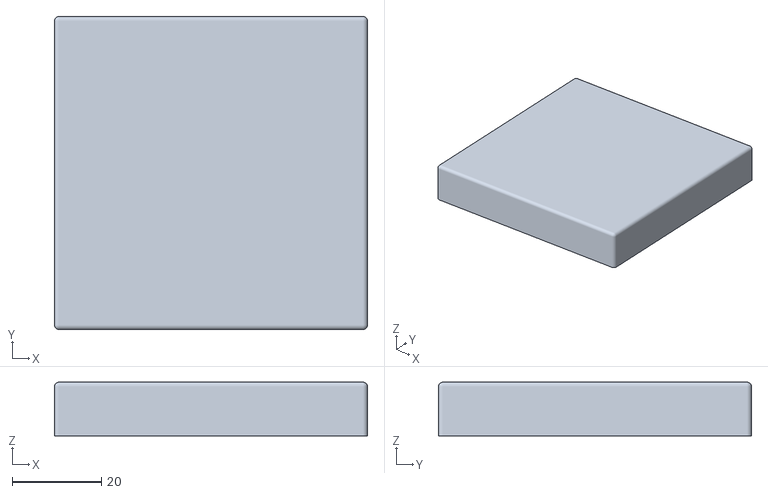
[picture p115: CAD file, 2026-09-05]
Generador de Chirp/Proyecto Integrador/caja/tapa continua.stl
70.0 x 70.0 x 12.0
