larfym/fmcw-radar/Generador de Chirp/Proyecto Integrador/caja/tapa_parte_3.stl

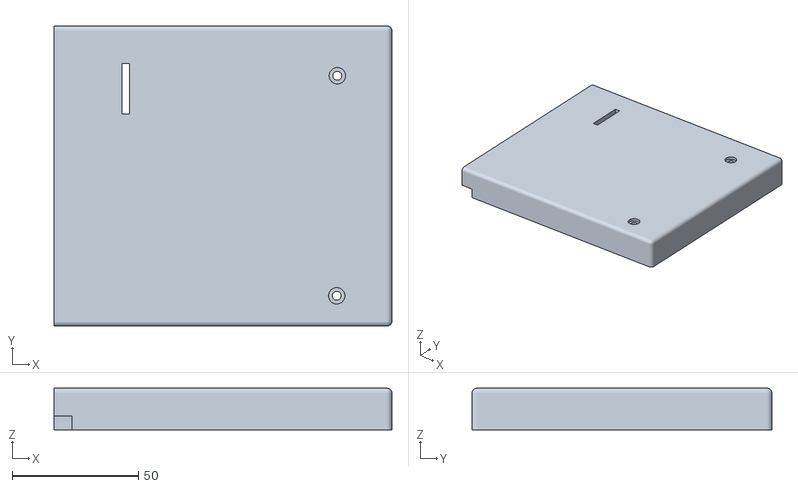
[picture p116: CAD file, 2026-09-05]
Generador de Chirp/Proyecto Integrador/caja/tapa_parte_3.stl
134.0 x 119.0 x 16.5
