larfym/fmcw-radar/Generador de Chirp/Proyecto Integrador/caja/caja_parte_2.stl

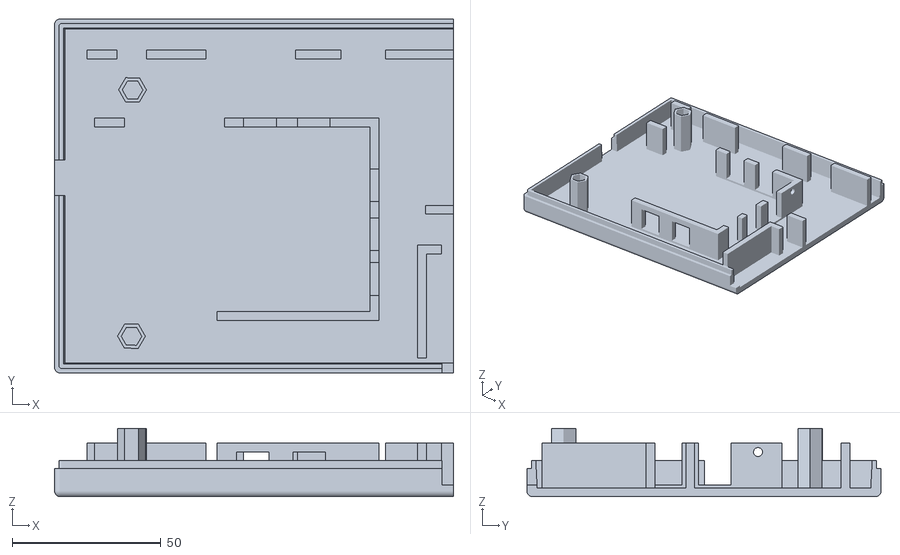
[picture p117: CAD file, 2026-09-05]
Generador de Chirp/Proyecto Integrador/caja/caja_parte_2.stl
134.0 x 119.0 x 23.0
