larfym/fmcw-radar/Generador de Chirp/Proyecto Integrador/caja/caja continua.stl

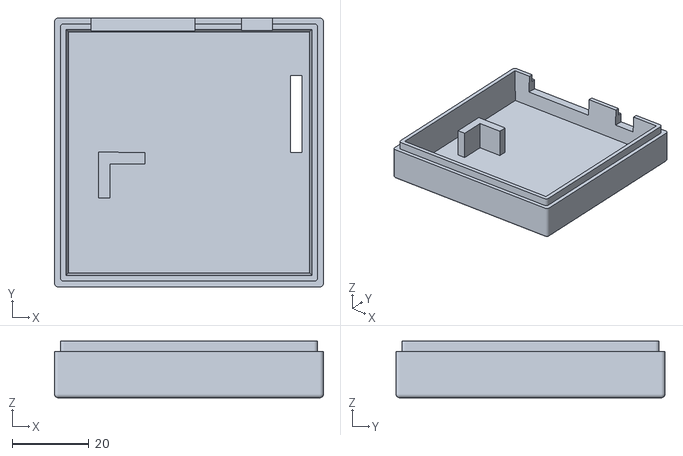
[picture p118: CAD file, 2026-09-05]
Generador de Chirp/Proyecto Integrador/caja/caja continua.stl
70.0 x 70.0 x 14.8
