larfym/fmcw-radar/Generador de Chirp/Proyecto Integrador/filtro lazo/C0805C104K5RACTU (1)/CAPC220145_88N_KEM.iges

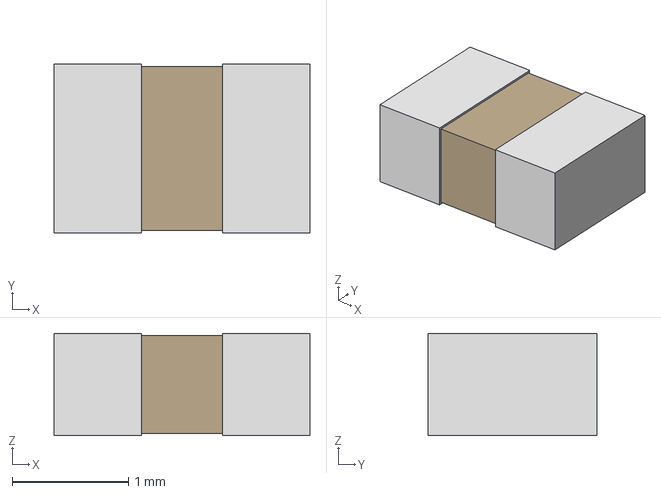
[picture p119: CAD file, 2026-09-05, an earlier design]
Generador de Chirp/Proyecto Integrador/filtro lazo/C0805C104K5RACTU (1)/CAPC220145_88N_KEM.iges
2.20 x 1.45 x 0.88 mm
