larfym/fmcw-radar/(list of files, cad)

Other CAD files:
Generador de Chirp/Proyecto Integrador/caja/tapa_parte_4.stl
