larfym/fmcw-radar/Generador de Chirp/Proyecto Integrador/filtro lazo/filtro1cobre.pdf

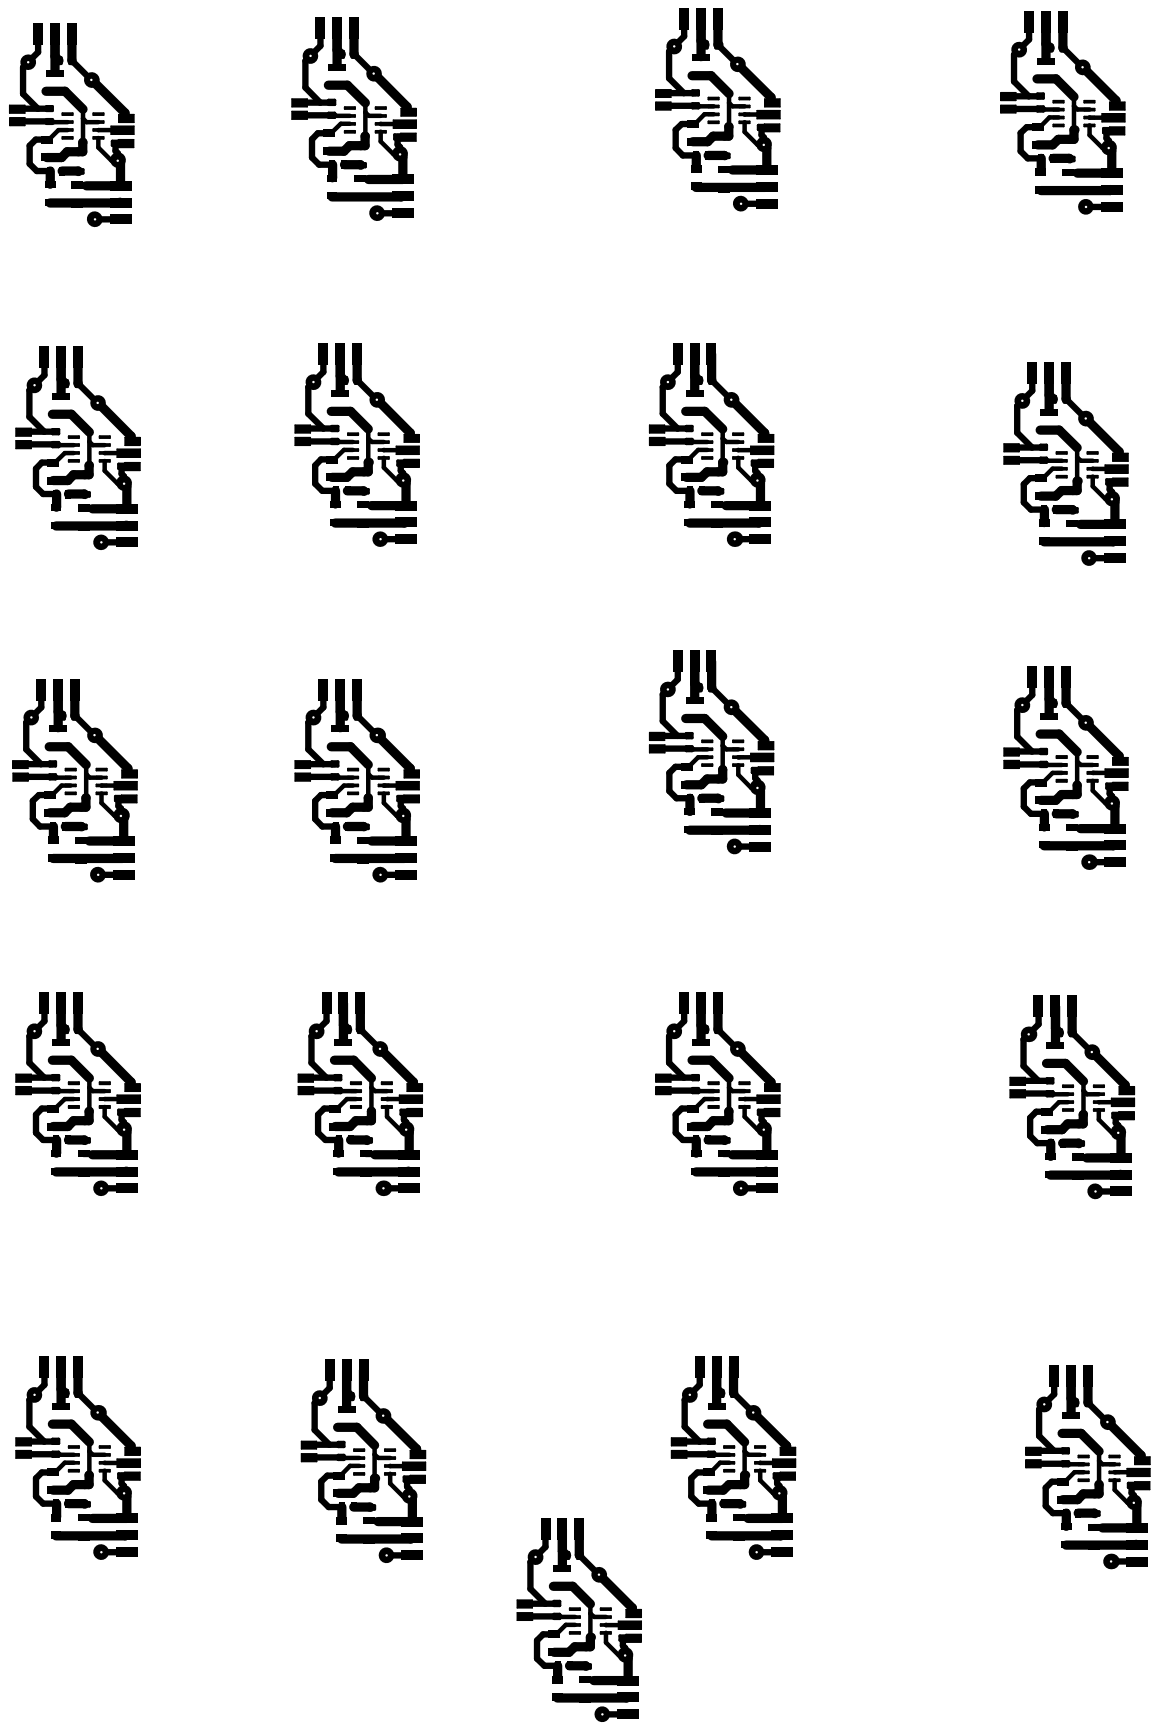
[picture p120: page 1]
