larfym/fmcw-radar/Generador de Chirp/Proyecto Integrador/filtro lazo/filtro2cobre.pdf

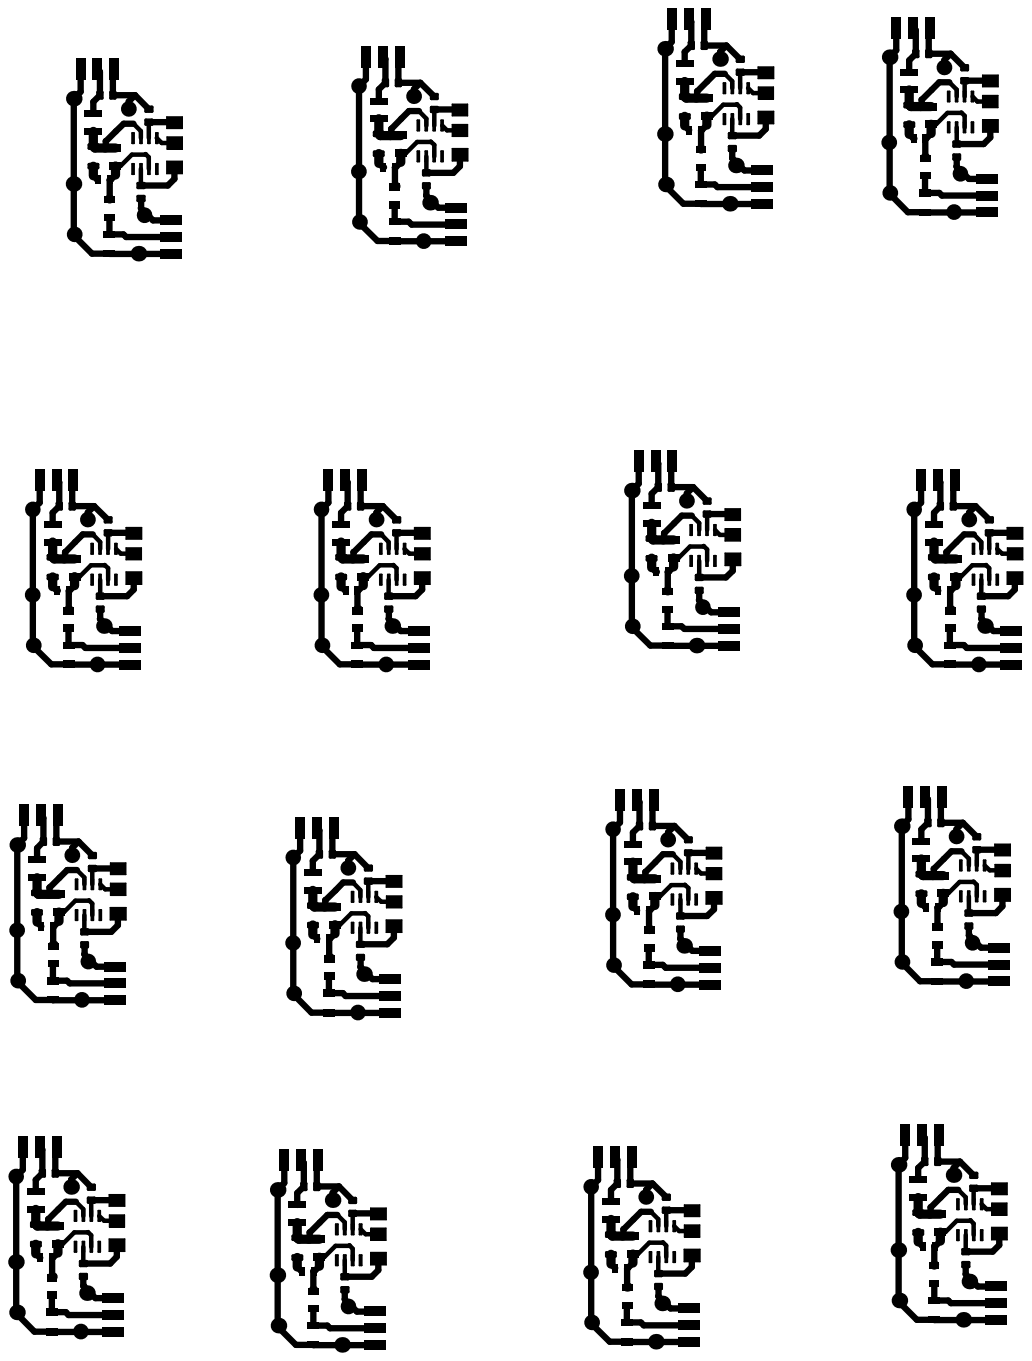
[picture p121: page 1]
