larfym/fmcw-radar/Generador de Chirp/Proyecto Integrador/filtro lazo/filtro3cobre.pdf

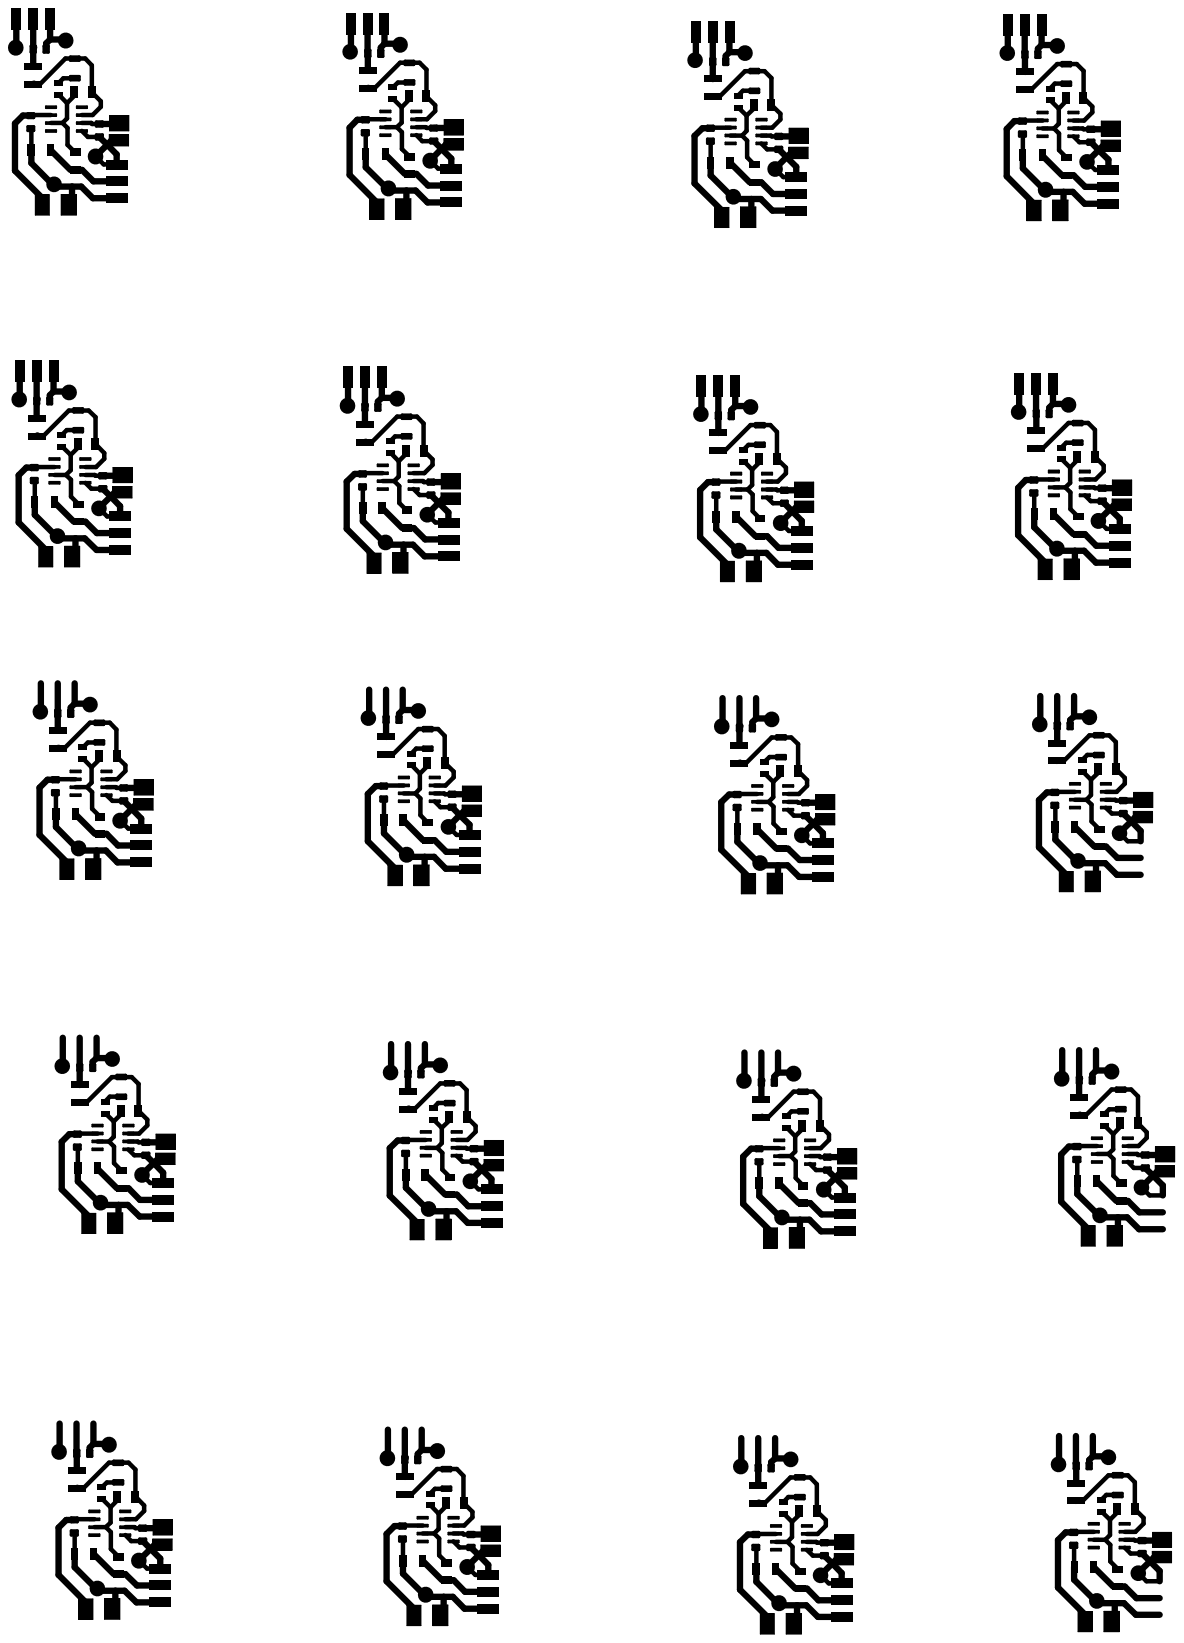
[picture p122: page 1]
