larfym/fmcw-radar/Generador de Chirp/Proyecto Integrador/filtrowilk/wilkfilt.pdf

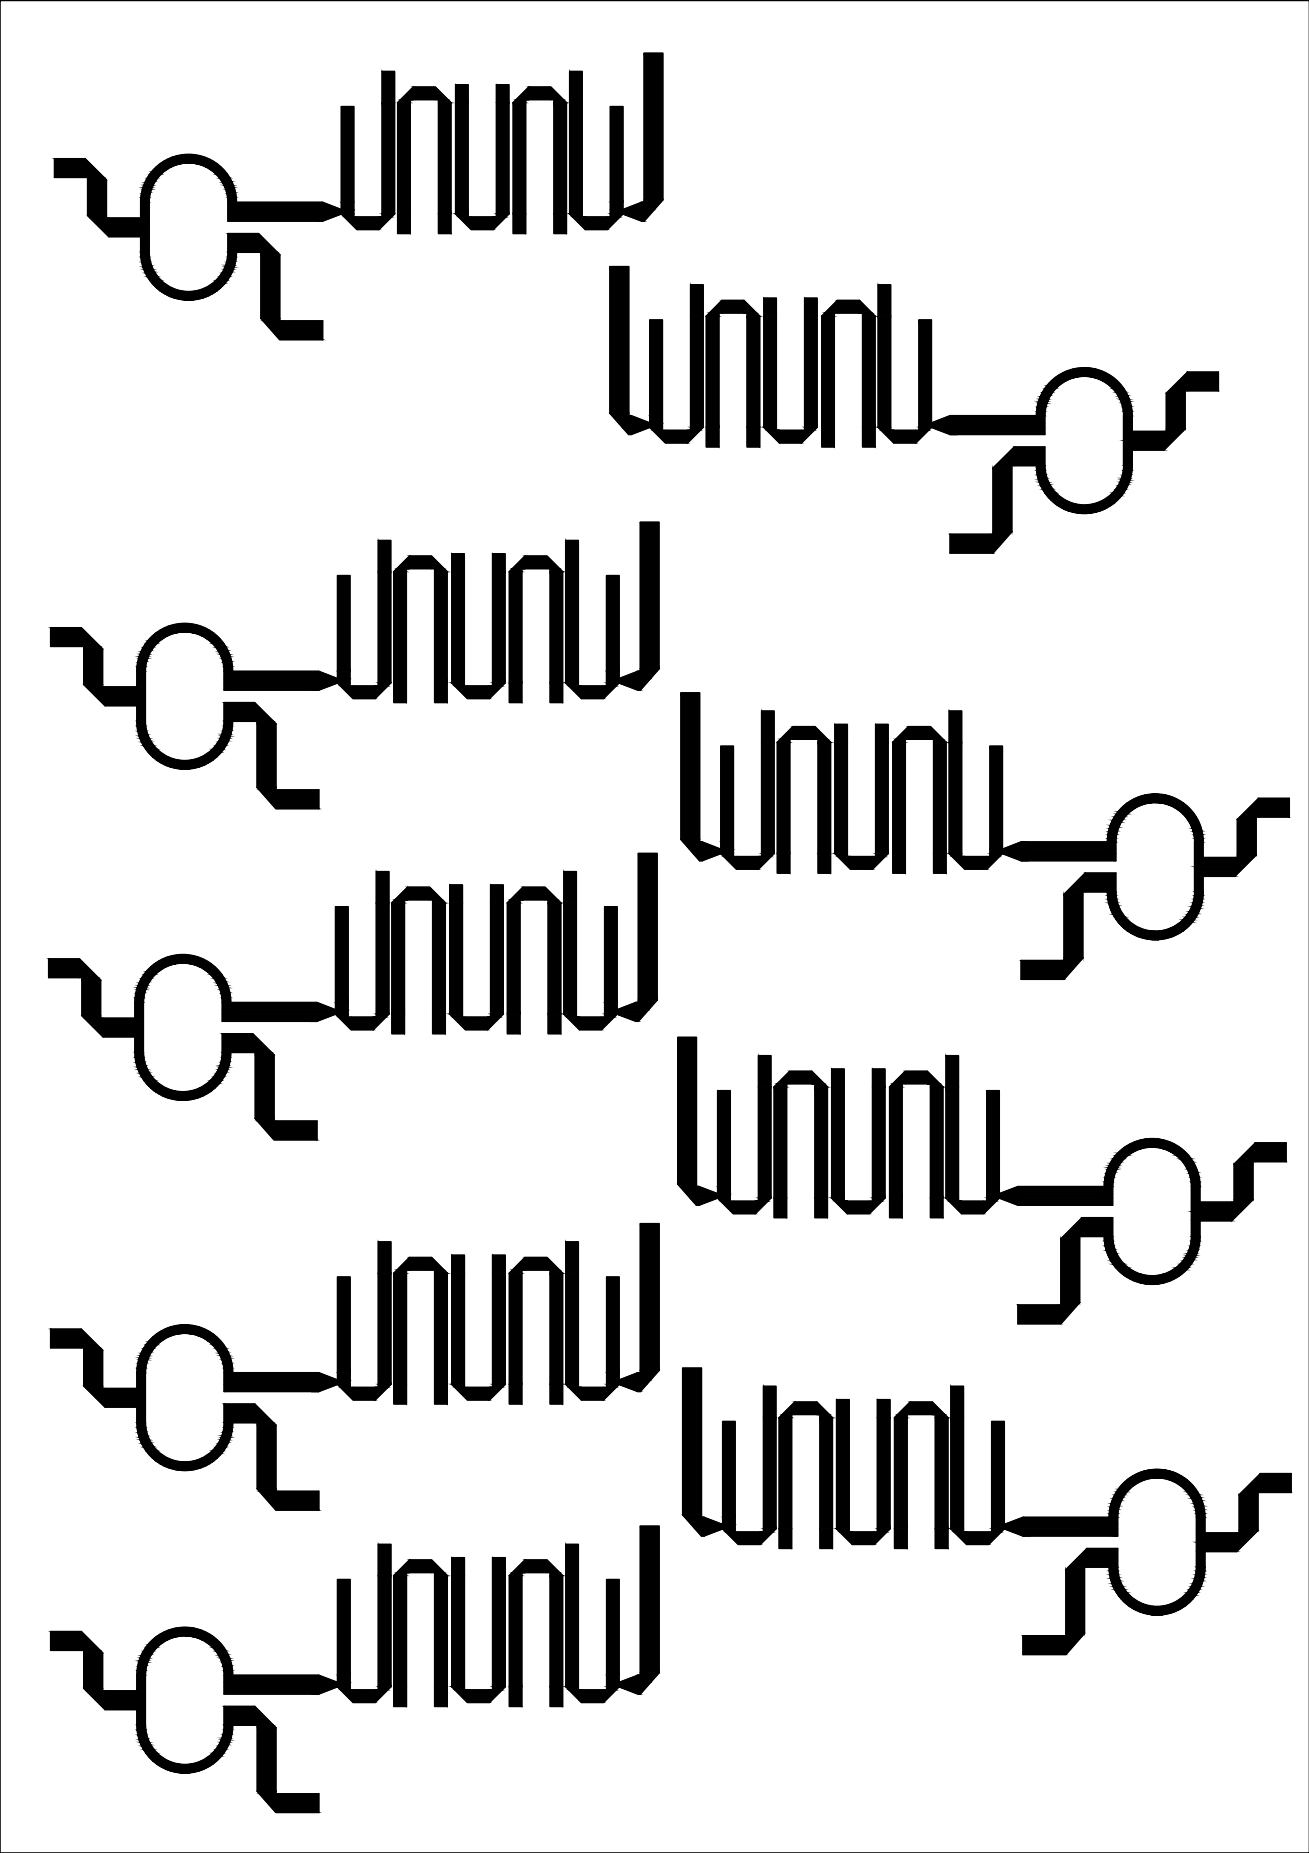
[picture p123: page 1]
