larfym/fmcw-radar/(list of files, drawings)

Other design files:
Generador de Chirp/Practica Supervisada/Simulaciones/Filtro_lazo/filtrolazo.ms14
