larfym/fmcw-radar/Generador de Chirp/Practica Supervisada/Simulaciones/Filtro_lazo/filtro_lazo/filtro_lazo.kicad_sch

## KiCad design Generador de Chirp/Practica Supervisada/Simulaciones/Filtro_lazo/filtro_lazo/filtro_lazo.kicad_sch (2026-09-05)

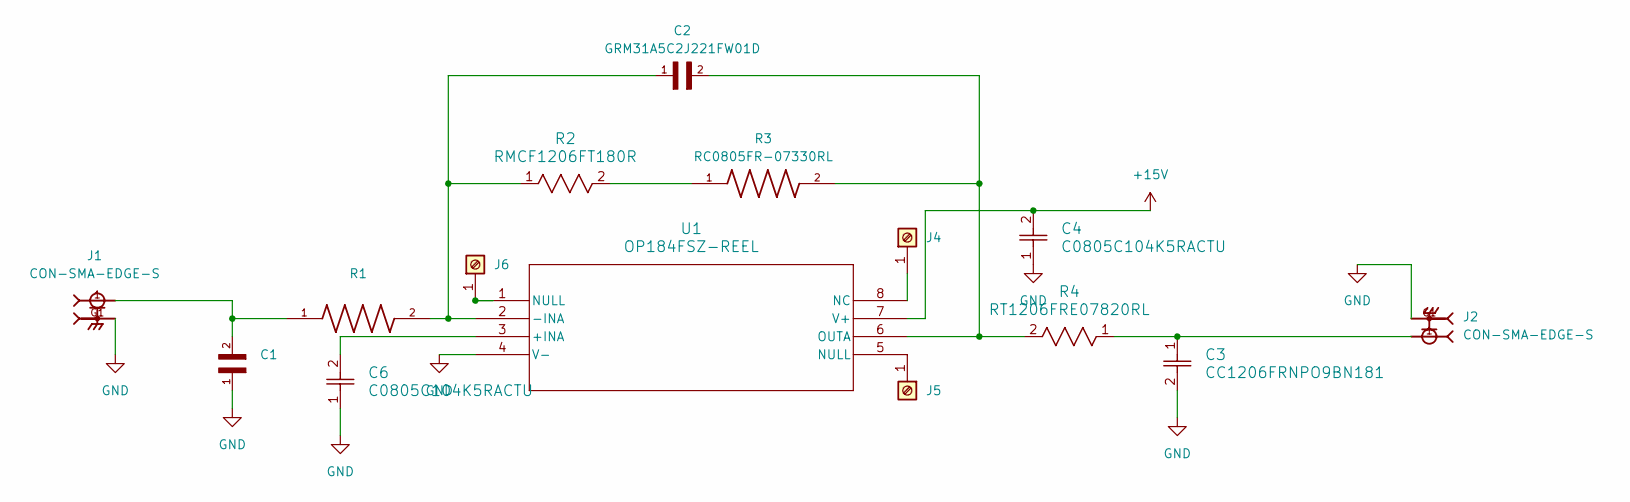
[picture p124: schematic filtro_lazo.kicad_sch]

Parts:
C1: GRM31A5C2J221FW01D; C_0805_2012Metric_Pad1.18x1.45mm_HandSolder; DigiKey_Part_Number 490-GRM31A5C2J221FW01DCT-ND
C2: GRM31A5C2J221FW01D; CAPC3216X100N; DigiKey_Part_Number 490-GRM31A5C2J221FW01DCT-ND
C3: CC1206FRNPO9BN181; CAP_CC1206_YAG
C4, C6: C0805C104K5RACTU; C_0805_2012Metric_Pad1.18x1.45mm_HandSolder
J1, J2: CON-SMA-EDGE-S; RFSOLUTIONS_CON-SMA-EDGE-S; PARTREV 1; DigiKey_Part_Number CON-SMA-EDGE-S-ND
J4, J5, J6: Screw_Terminal_01x01
R1: RT1210FRE07100RL; RESC3126X65N; DigiKey_Part_Number 13-RT1210FRE07100RLCT-ND
R2: RMCF1206FT180R; L_1206_3216Metric
R3: RC0805FR-07330RL; RESC2012X60N
R4: RT1206FRE07820RL; RC1206N_YAG
U1: OP184FSZ-REEL; SOIC-8_3.9x4.9mm_P1.27mm

Connections:
+15V: C4.2, U1.7 (V+)
GND: C1.1, C3.2, C4.1, C6.1, J1.G1, J1.G2, J1.G3, J1.G4, J2.G1, J2.G2, J2.G3, J2.G4, U1.4 (V-)
unnamed: C1.2, J1.1, R1.1
unnamed: C2.1, R1.2, R2.1, U1.2 (-INA)
unnamed: C2.2, R3.2, R4.2, U1.6 (OUTA)
unnamed: C3.1, J2.1, R4.1
unnamed: C6.2, U1.3 (+INA)
unnamed: J4.1, U1.8 (NC)
unnamed: J5.1, U1.5 (NULL)
unnamed: J6.1, U1.1 (NULL)
unnamed: R2.2, R3.1
